Stustup/C-Audio_Schmupf_Amp_CASA/README.md

# Schmupf-Amp (CASA)
Small Stereo Headphone Amp with microphone passthrough fitting into a nice case.

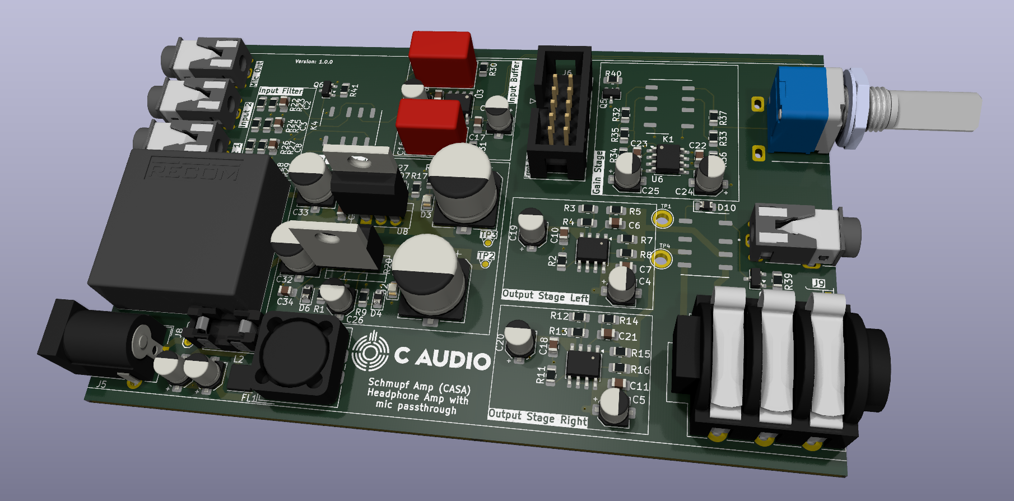
[picture p1: Docs/Mainbaord_3D-Model.png]
3D View of Mainboard


Simple leader follower parallel opamp topology.

# Signal Path 
Input -> Filter -> Input switch -> Input Buffer -> Volume control -> Voltage Gain Stage -> Current Gain Stage -> Output

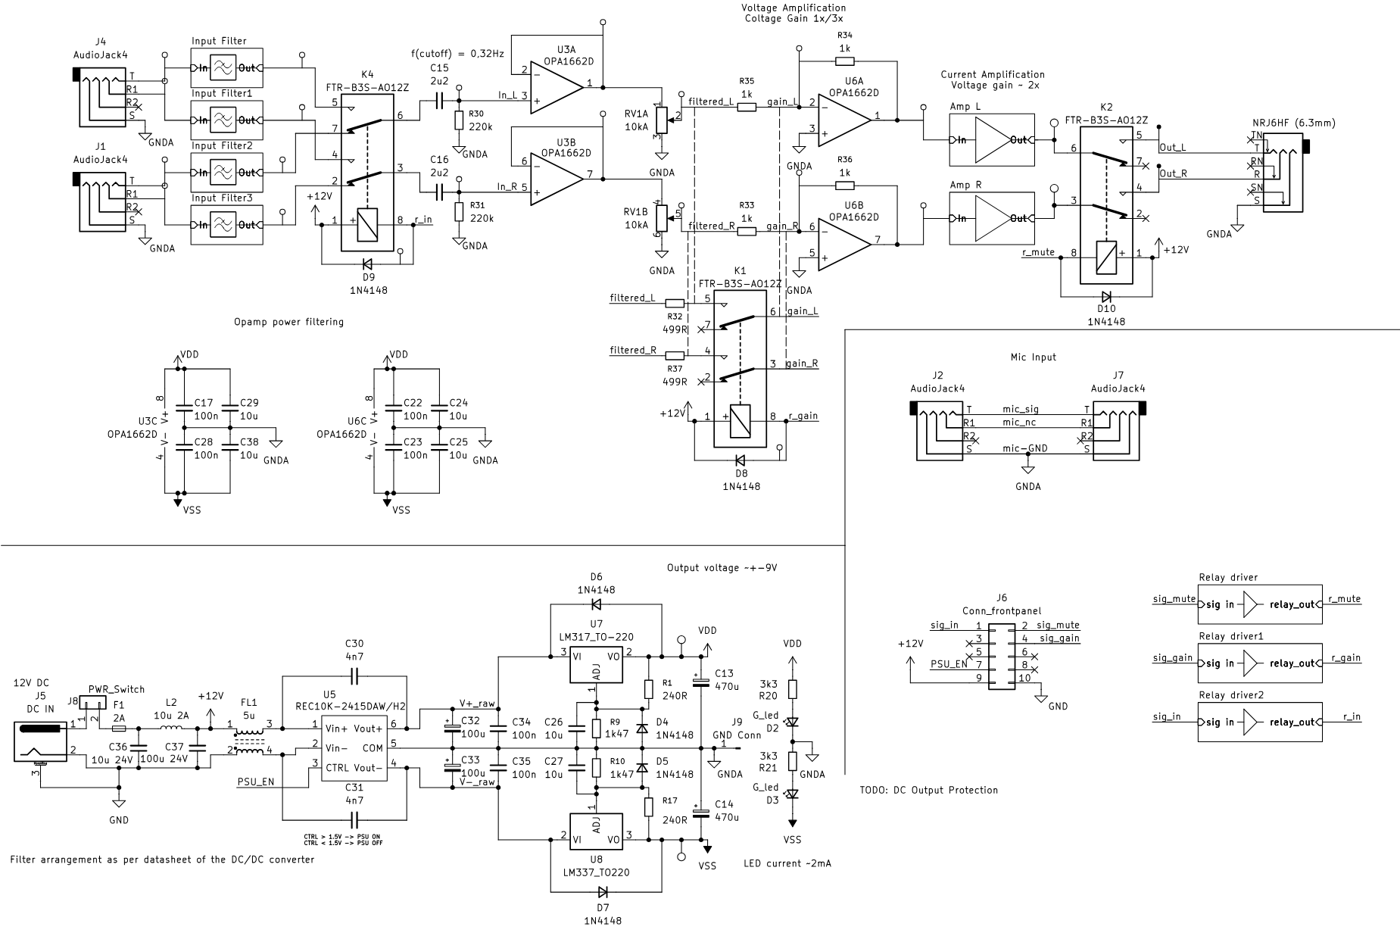
[picture p2: Docs/Schematic CASA.png]
Schematic


Bipolar linear post regulated power supply derived from 12V with a REC10K +-12V Module. Voltage for the opamps is +-9V.d
