Stustup/C-Audio_Schmupf_Amp_CASA/Docs/XRK Class A latest Version.jpg

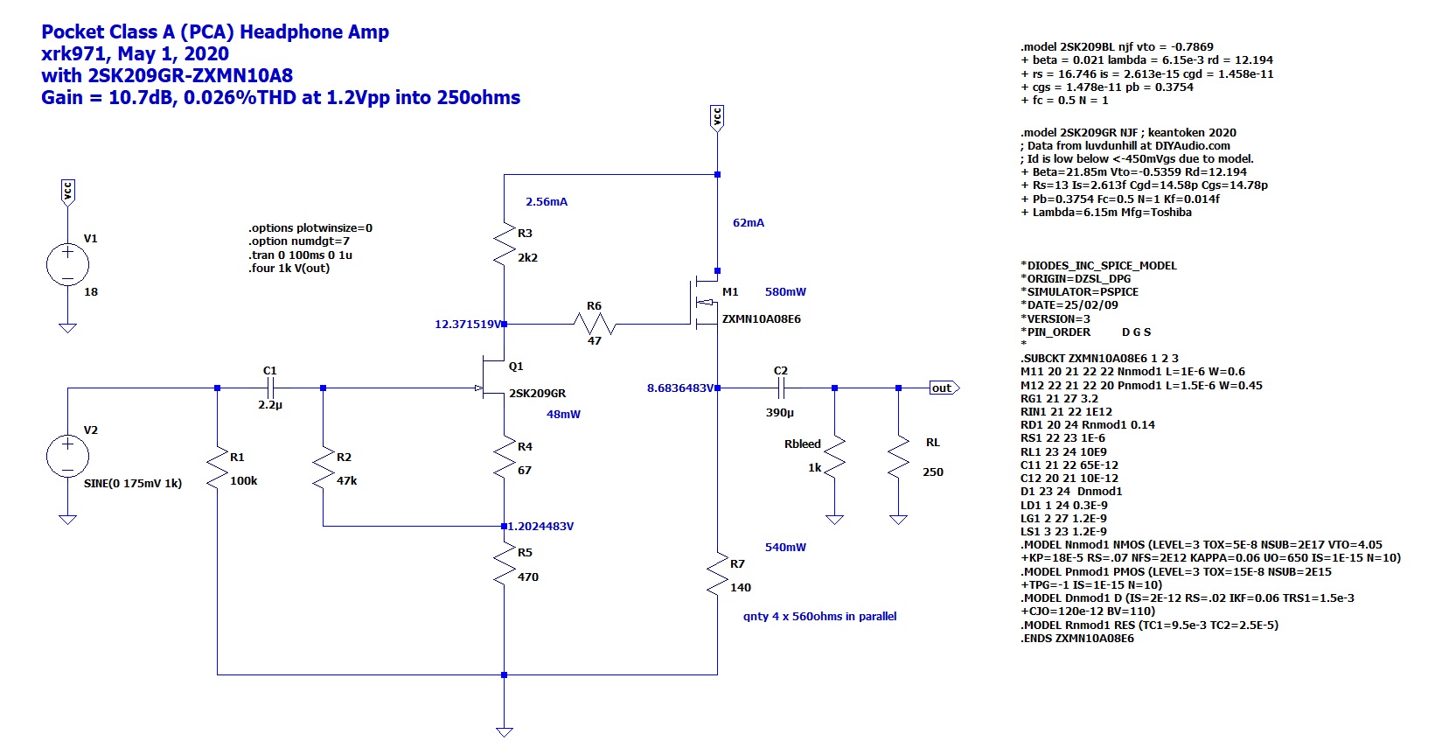
Docs/XRK Class A latest Version.jpg
