Stustup/C-Audio_Schmupf_Amp_CASA/Hardware/External Stuff/cliff-fc68125-1.snapshot.1/Screenshot 2020-02-27 at 16.49.09.png

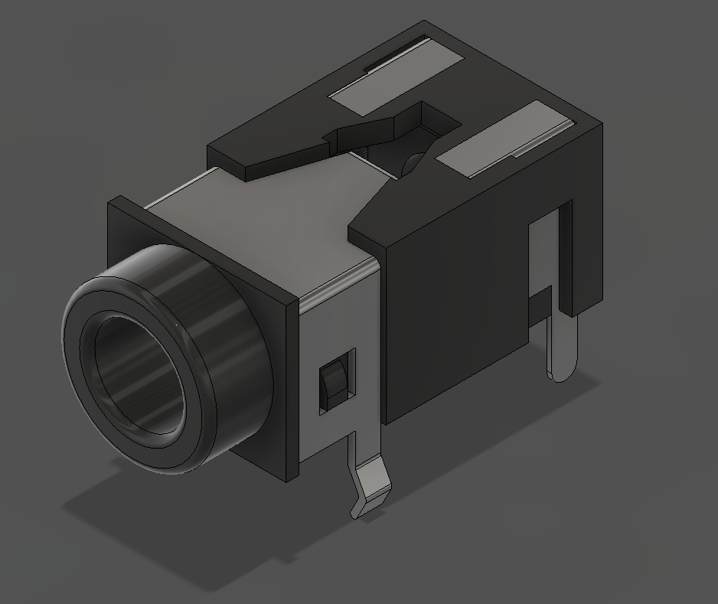
Hardware/External Stuff/cliff-fc68125-1.snapshot.1/Screenshot 2020-02-27 at 16.49.09.png
