Stustup/C-Audio_Schmupf_Amp_CASA/Hardware/Symbols/low pass filter.png

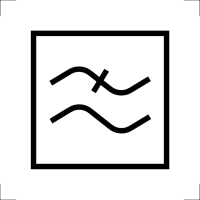
Hardware/Symbols/low pass filter.png
