Stustup/C-Audio_Schmupf_Amp_CASA/3D-CAD/Schmupf amp CASA.FCStd

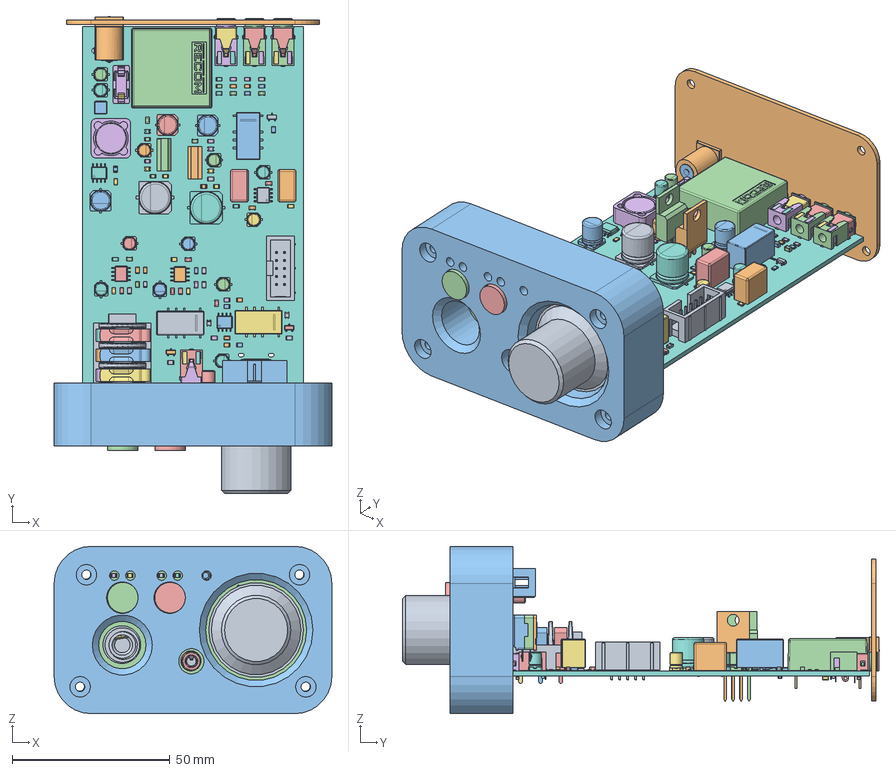
[picture p6: CAD file, 2026-03-26]
3D-CAD/Schmupf amp CASA.FCStd
88.0 x 151.1 x 53.0 mm
D_0805_2012Metric
LED_0805_2012Metric
CP_Elec_6.3x7.7
C_0805_2012Metric
C_0805_2012Metric001
R_0805_2012Metric
R_0805_2012Metric001
R_0805_2012Metric002
CP_Elec_10x10.5
R_0805_2012Metric003
R_0805_2012Metric004
C_0805_2012Metric002
Telo konektora
Kontakt most
Kontakt 1
Kontakt 002
Kontakt 2
R_0805_2012Metric005
C-Audio Schmupf Amp (CASA) 1.15.1
C-Audio Schmupf Amp (CASA) 1.15.002
C-Audio Schmupf Amp (CASA) 1.15.003
C-Audio Schmupf Amp (CASA) 1.15.004
C-Audio Schmupf Amp (CASA) 1.15.005
C-Audio Schmupf Amp (CASA) 1.15.006
C-Audio Schmupf Amp (CASA) 1.15.007
C-Audio Schmupf Amp (CASA) 1.15.008
C-Audio Schmupf Amp (CASA) 1.15.009
C-Audio Schmupf Amp (CASA) 1.15.010
SO-8_3.9x4.9mm_P1.27mm
R_0805_2012Metric006
D_0805_2012Metric001
CP_Elec_4x5.8
R_0805_2012Metric007
TO-220-3_Vertical
R_0805_2012Metric008
Telo konektora001
Kontakt most001
Kontakt 004
Kontakt 005
Kontakt 007
R_0805_2012Metric009
R_0805_2012Metric010
CP_Elec_4x5.009
TO-220-3_Vertical001
C_Rect_L10.3mm_W5.7mm_P7.50mm_MKS4
R_0805_2012Metric011
R_0805_2012Metric012
C_0805_2012Metric003
SOT-23
SO-8_3.9x4.9mm_P1.27mm001
R_0805_2012Metric013
C_0805_2012Metric004
CP_Elec_4x5.010
L_Bourns_SRR1260
D_0805_2012Metric002
CP_Elec_4x5.011
R_0805_2012Metric014
R_0805_2012Metric015
Relay_DPDT_Kemet_EE2_NU
R_0805_2012Metric016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
