Stustup/C-Audio_Schmupf_Amp_CASA/Hardware/3D-models/CP_Elec_4x5.8.step

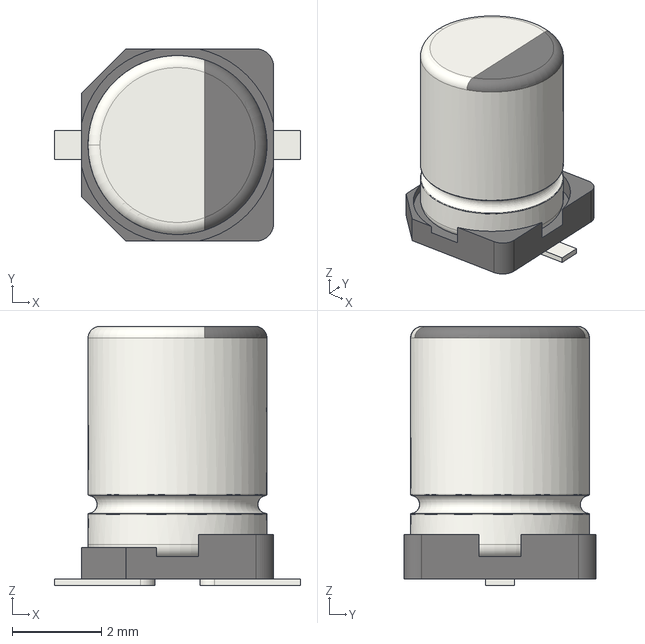
[picture p7: CAD file, 2025-12-11]
Hardware/3D-models/CP_Elec_4x5.8.step
5.50 x 4.30 x 5.80 mm
