Stustup/C-Audio_Schmupf_Amp_CASA/Hardware/C-Audio Schmupf Amp (CASA) Backplate/3D/C-Audio Schmupf Amp (CASA) Backplate.step

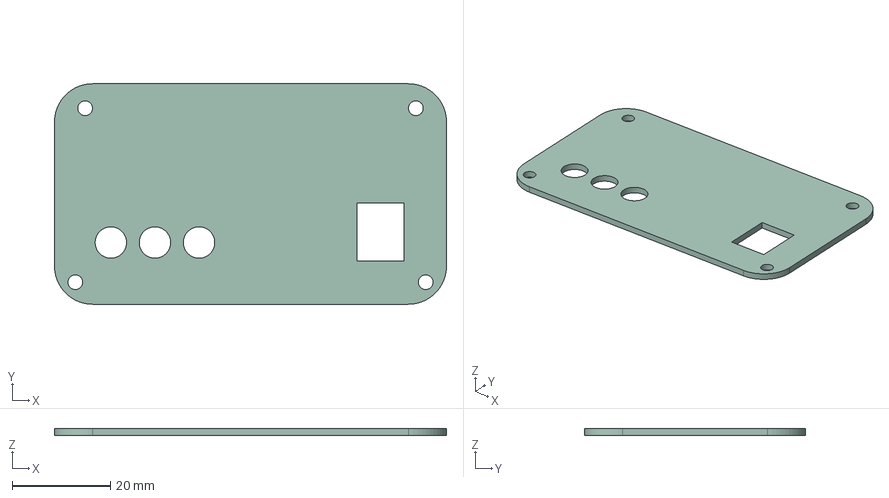
[picture p8: CAD file, 2025-12-11]
Hardware/C-Audio Schmupf Amp (CASA) Backplate/3D/C-Audio Schmupf Amp (CASA) Backplate.step
80.0 x 45.0 x 1.51 mm
