Stustup/C-Audio_Schmupf_Amp_CASA/Hardware/C-Audio Schmupf Amp (CASA) Backplate/backplate_CASA_dimensions.dxf

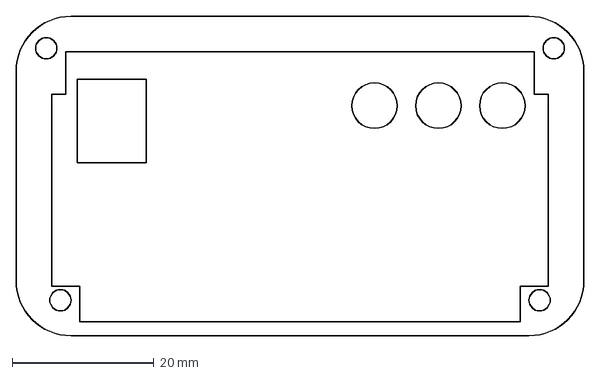
[picture p9: CAD file, 2025-12-11]
Hardware/C-Audio Schmupf Amp (CASA) Backplate/backplate_CASA_dimensions.dxf
80.0 x 45.0 mm
