Stustup/C-Audio_Schmupf_Amp_CASA/Hardware/C-Audio Schmupf Amp (CASA) Frontplate/Schmupf amp CASA_Frontplate.dxf

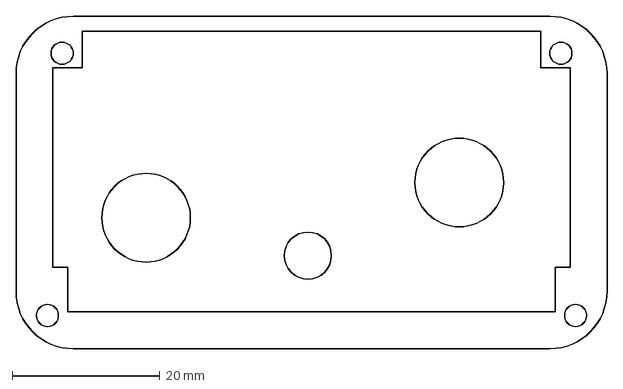
[picture p10: CAD file, 2025-12-11]
Hardware/C-Audio Schmupf Amp (CASA) Frontplate/Schmupf amp CASA_Frontplate.dxf
80.0 x 45.0 mm
