Stustup/C-Audio_Schmupf_Amp_CASA/Hardware/C-Audio Schmupf Amp (CASA).step

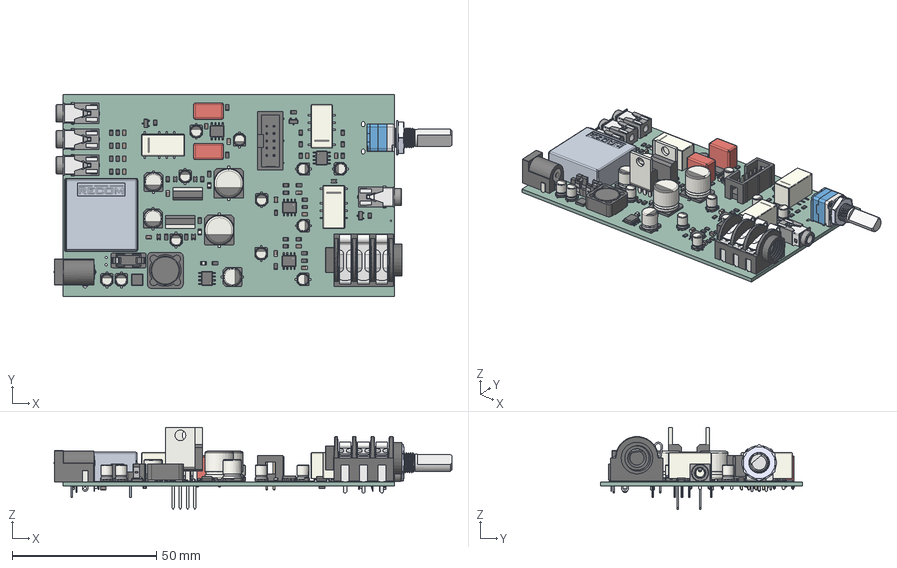
[picture p11: CAD file, 2025-12-11]
Hardware/C-Audio Schmupf Amp (CASA).step
138.0 x 70.0 x 28.5 mm
LED_0805_2012Metric x 3
CP_Elec_6.3x7.7 x 3
C_0805_2012Metric x 18
R_0805_2012Metric x 38
CP_Elec_10x10.5 x 2
Telo konektora x 4
Kontakt most x 4
Kontakt 1 x 4
Kontakt 2 x 4
C-Audio Schmupf Amp (CASA) 1.14.1
SO-8_3.9x4.9mm_P1.27mm x 2
D_0805_2012Metric x 7
CP_Elec_4x5.8 x 12
TO-220-3_Vertical x 2
C_Rect_L10.3mm_W5.7mm_P7.50mm_MKS4 x 2
SOT-23 x 3
L_Bourns_SRR1260
Relay_DPDT_Kemet_EE2_NU x 3
SOIC-8_3.9x4.9mm_P1.27mm x 3
IDC-Header_2x05_P2.54mm_Vertical
RK097x-Cover
RK097x-Housing2
NMJ6HCD2
BarrelJack_Horizontal
Fuseholder_Schurter_0031.7701.xx
L_APV_ANR4010
C-Audio Schmupf Amp (CASA)_PCB
