Stustup/C-Audio_Schmupf_Amp_CASA/Hardware/3D-models/Audio Jack 3.5 mm  Cliff FC68125.step

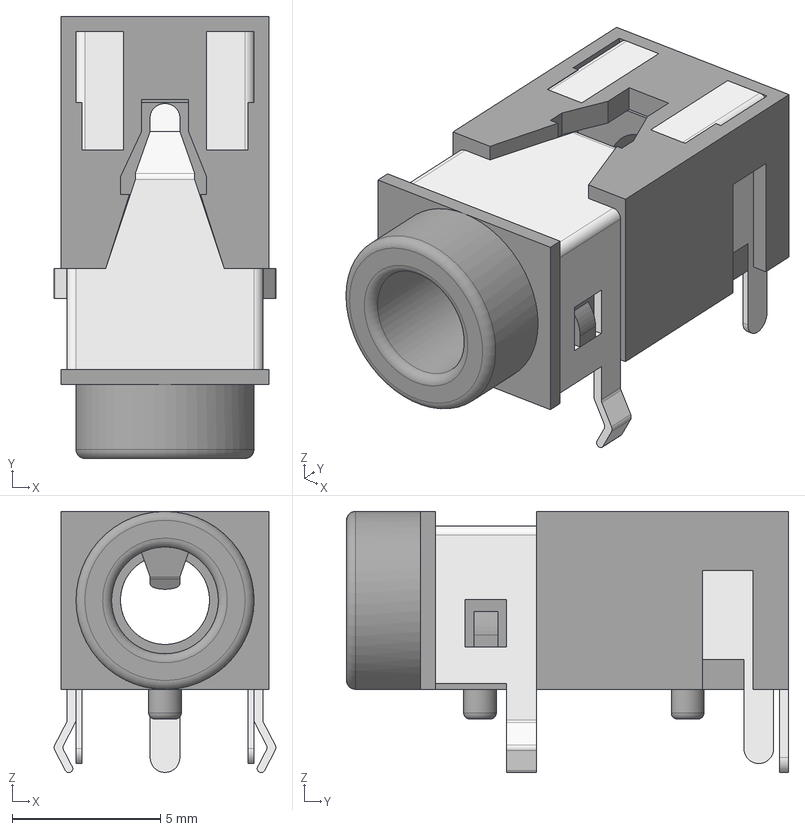
[picture p12: CAD file, 2025-12-11]
Hardware/External Stuff/cliff-fc68125-1.snapshot.1/Audio Jack 3.5 mm Cliff FC68125.step
7.47 x 14.9 x 8.81 mm
Telo konektora
Kontakt most
Kontakt 1
Kontakt 2
