Stustup/C-Audio_Schmupf_Amp_CASA/Hardware/REC10K-2415DAW_H2/REC10K-2415DAW_H2.STEP

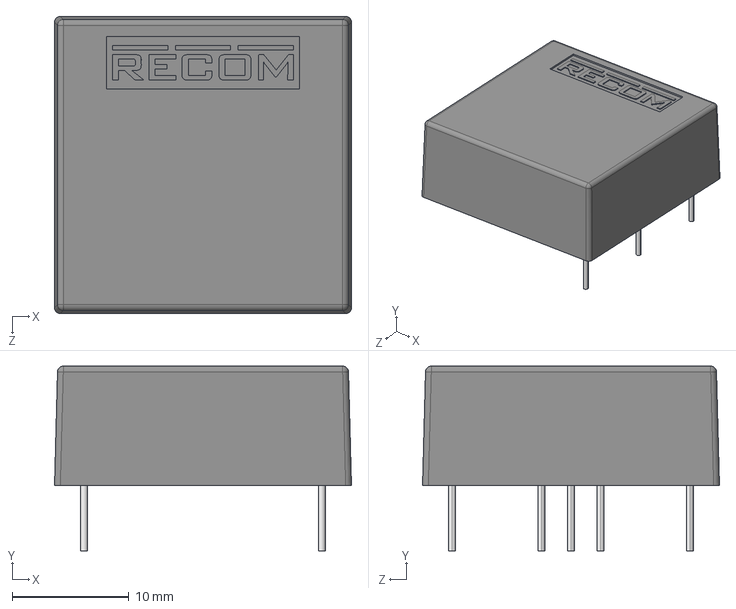
[picture p13: CAD file, 2025-12-11]
Hardware/REC10K-2415DAW_H2/REC10K-2415DAW_H2.STEP
25.4 x 15.8 x 25.4 mm
