Stustup/C-Audio_Schmupf_Amp_CASA/Hardware/TechDraw/Schmupf amp CASA_Frontplate.dxf

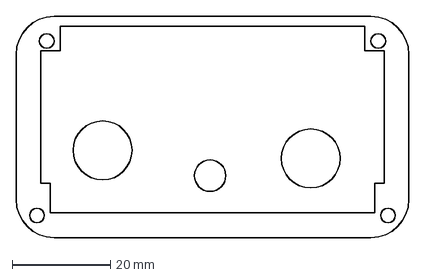
[picture p14: CAD file, 2025-12-11]
Hardware/TechDraw/Schmupf amp CASA_Frontplate.dxf
80.0 x 45.0 mm
