Stustup/C-Audio_Schmupf_Amp_CASA/3D-CAD/C-Audio Schmupf Amp (CASA) Frontplate.step

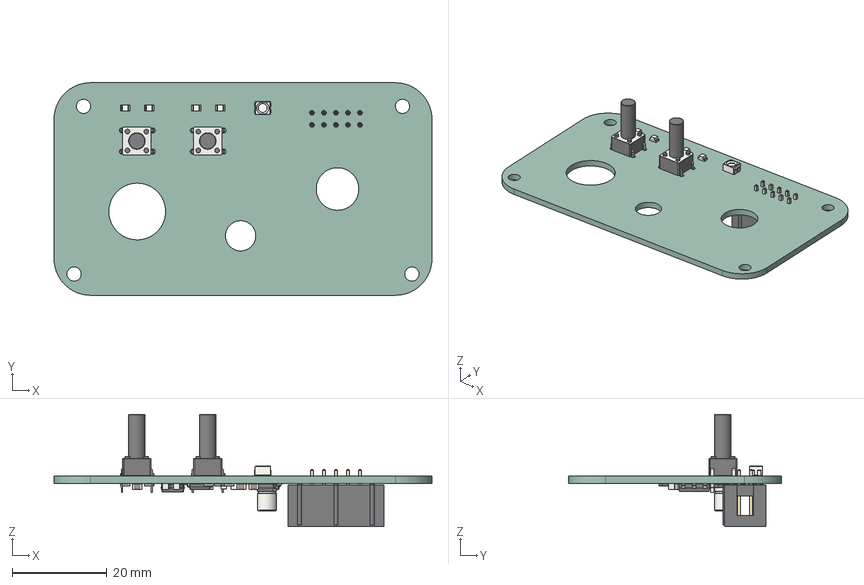
[picture p15: CAD file, 2026-01-21]
3D-CAD/C-Audio Schmupf Amp (CASA) Frontplate.step
80.0 x 45.0 x 23.8 mm
LED_0805_2012Metric x 5
SW_PUSH_6mm_H13mm x 2
LED_RGB_Wuerth-PLCC4_3.2x2.8mm_150141M173100
SOIC-8_3.9x4.9mm_P1.27mm
SOT-23 x 3
TSSOP-20_4.4x6.5mm_P0.65mm
R_0805_2012Metric x 15
IDC-Header_2x05_P2.54mm_Vertical
C_0805_2012Metric x 7
CP_Elec_4x5.8
SOT-223
C-Audio Schmupf Amp (CASA) Frontplate_PCB
