Stustup/C-Audio_Schmupf_Amp_CASA/Hardware/3D-models/SO-8_3.9x4.9mm_P1.27mm.step

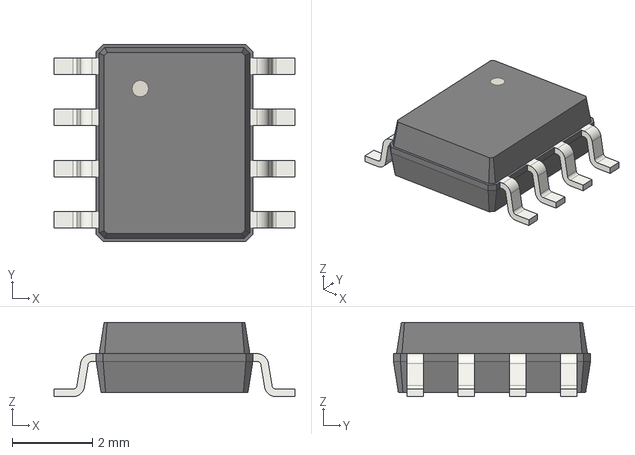
[picture p16: CAD file, 2025-12-11]
Hardware/3D-models/SO-8_3.9x4.9mm_P1.27mm.step
6.00 x 4.91 x 1.85 mm
