Stustup/C-Audio_Schmupf_Amp_CASA/Hardware/3D-models/LED_0805_2012Metric.step

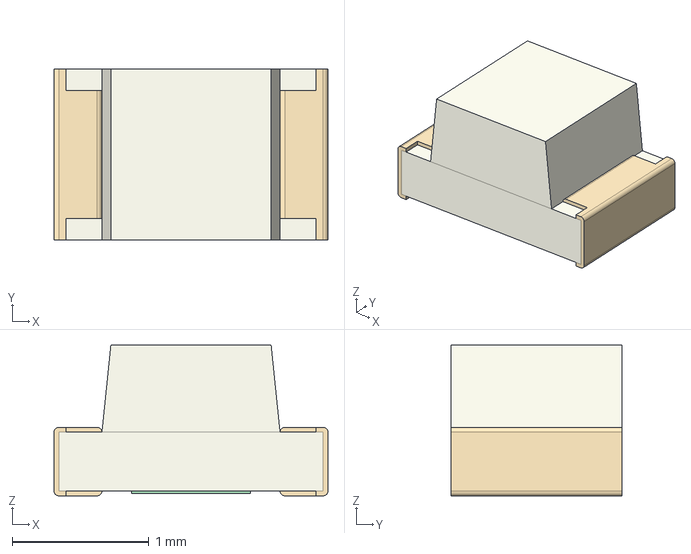
[picture p17: CAD file, 2025-12-11]
Hardware/3D-models/LED_0805_2012Metric.step
2.00 x 1.25 x 1.10 mm
