Stustup/C-Audio_Schmupf_Amp_CASA/Hardware/3D-models/L_APV_ANR4010.step

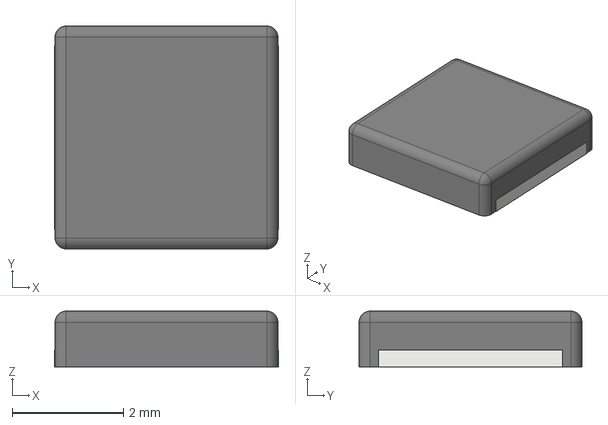
[picture p18: CAD file, 2025-12-11]
Hardware/3D-models/L_APV_ANR4010.step
4.02 x 4.00 x 1.00 mm
