Stustup/C-Audio_Schmupf_Amp_CASA/Hardware/3D-models/NMJ6HCD2.step

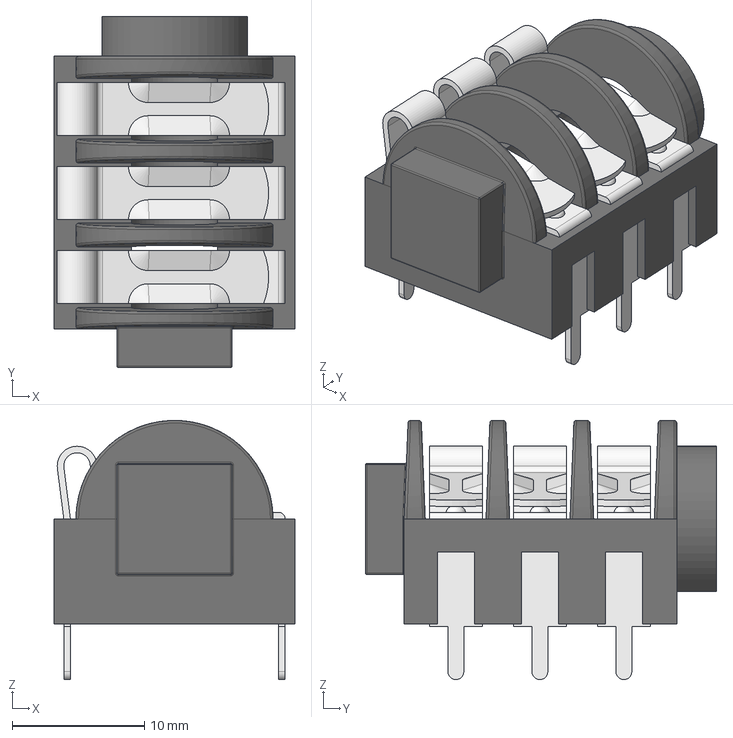
[picture p19: CAD file, 2025-12-11]
Hardware/3D-models/NMJ6HCD2.step
18.2 x 26.5 x 19.6 mm
