Stustup/C-Audio_Schmupf_Amp_CASA/Hardware/3D-models/L_Bourns_SRR1260.step

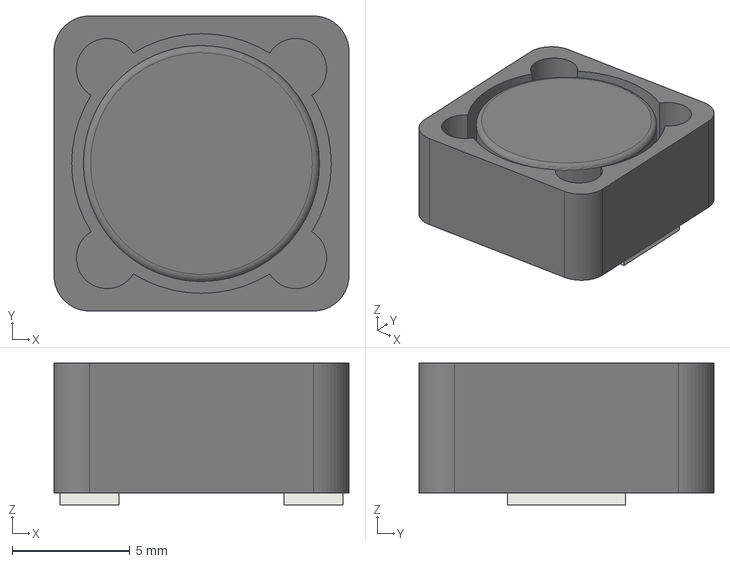
[picture p20: CAD file, 2025-12-11]
Hardware/3D-models/L_Bourns_SRR1260.step
12.5 x 12.5 x 6.00 mm
