Stustup/C-Audio_Schmupf_Amp_CASA/Hardware/3D-models/BarrelJack_Horizontal.step

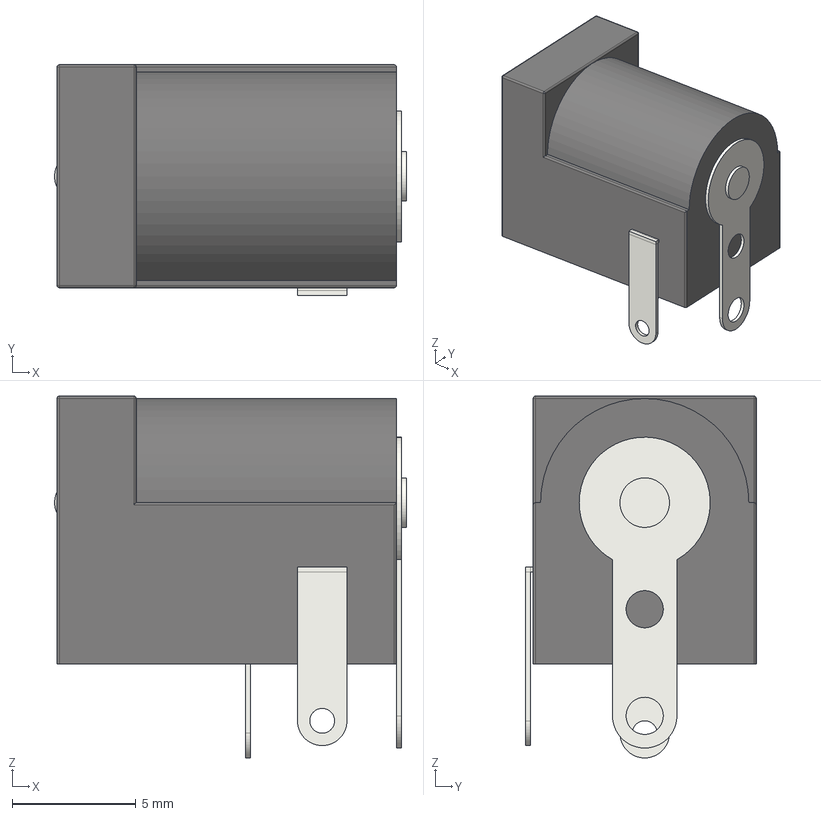
[picture p21: CAD file, 2025-12-11]
Hardware/3D-models/BarrelJack_Horizontal.step
14.2 x 9.30 x 14.6 mm
