Stustup/C-Audio_Schmupf_Amp_CASA/Hardware/3D-models/D_0805_2012Metric.step

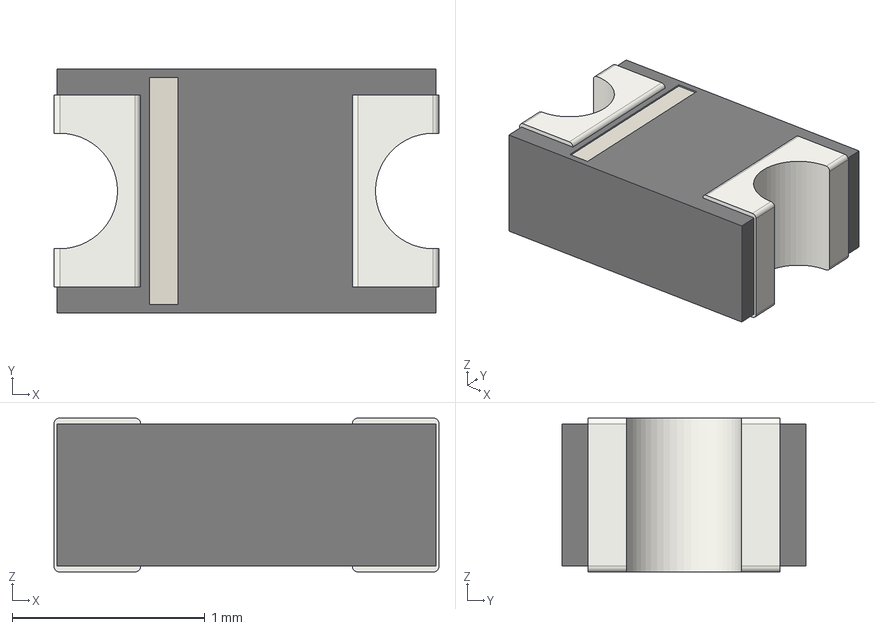
[picture p22: CAD file, 2025-12-11]
Hardware/3D-models/D_0805_2012Metric.step
2.00 x 1.27 x 0.8 mm
