Stustup/C-Audio_Schmupf_Amp_CASA/Hardware/3D-models/C_0805_2012Metric.step

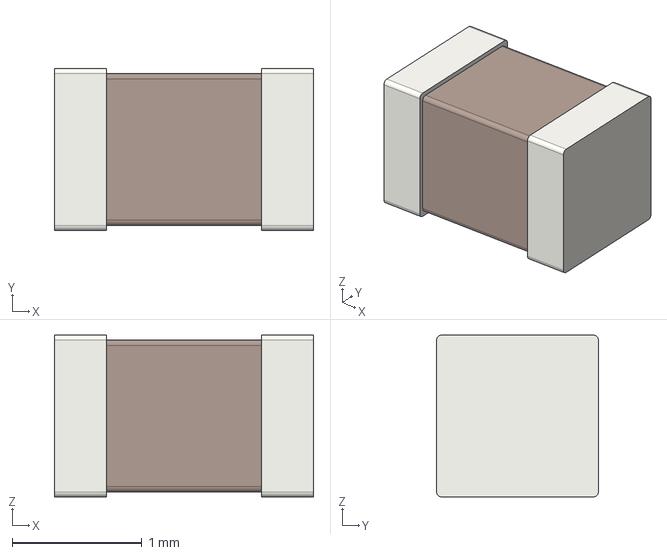
[picture p23: CAD file, 2025-12-11]
Hardware/3D-models/C_0805_2012Metric.step
2.00 x 1.25 x 1.25 mm
