Stustup/C-Audio_Schmupf_Amp_CASA/Hardware/3D-models/Fuseholder_Schurter_0031.7701.xx.step

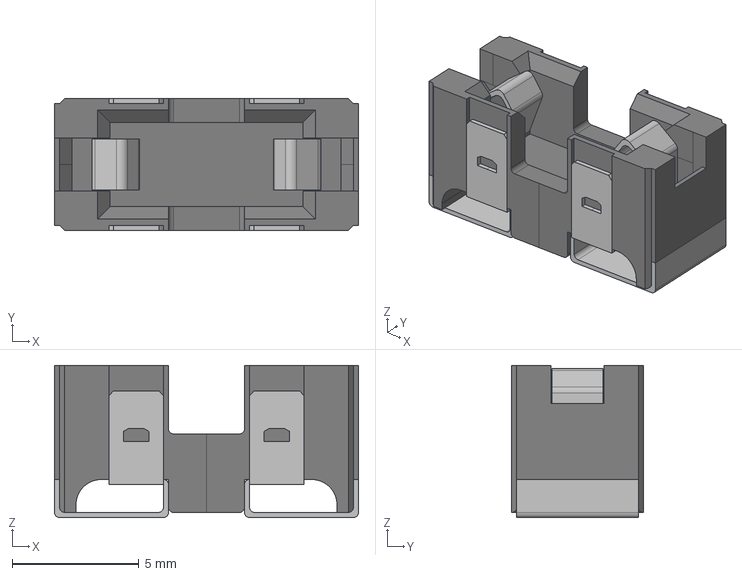
[picture p24: CAD file, 2025-12-11]
Hardware/3D-models/Fuseholder_Schurter_0031.7701.xx.step
12.0 x 5.20 x 6.00 mm
