Stustup/C-Audio_Schmupf_Amp_CASA/Hardware/3D-models/SOT-23.step

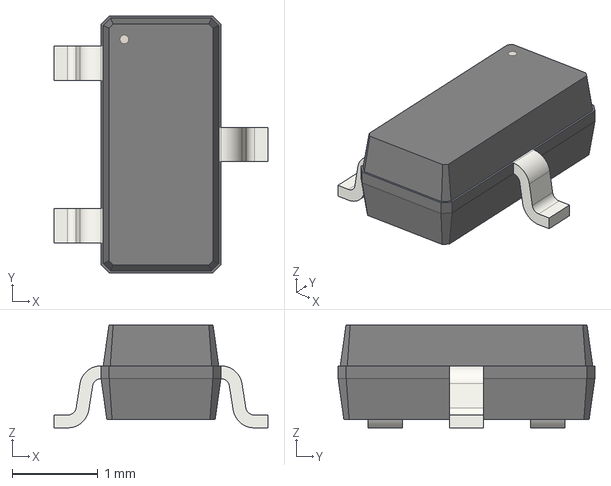
[picture p25: CAD file, 2025-12-11]
Hardware/3D-models/SOT-23.step
2.50 x 3.00 x 1.20 mm
