Stustup/C-Audio_Schmupf_Amp_CASA/Hardware/3D-models/TO-220-3_Vertical.step

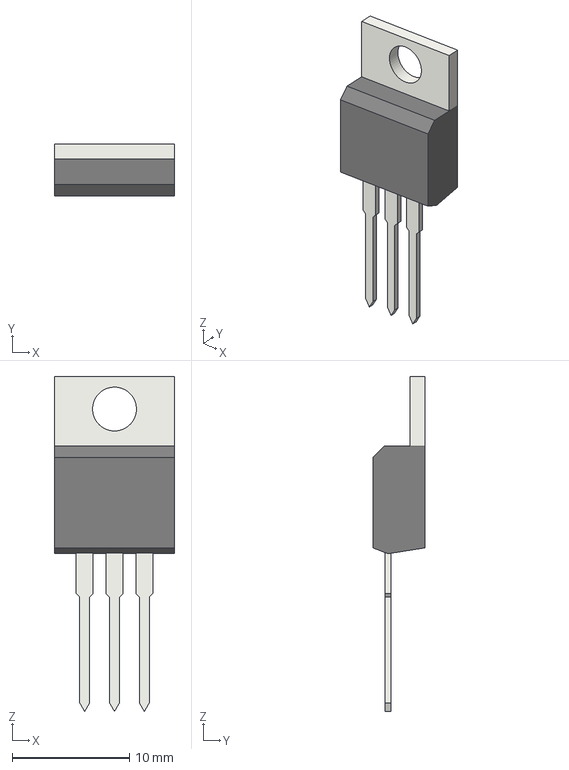
[picture p26: CAD file, 2025-12-11]
Hardware/3D-models/TO-220-3_Vertical.step
10.2 x 4.46 x 28.5 mm
