Stustup/C-Audio_Schmupf_Amp_CASA/Hardware/3D-models/C_Rect_L10.3mm_W5.7mm_P7.50mm_MKS4.step

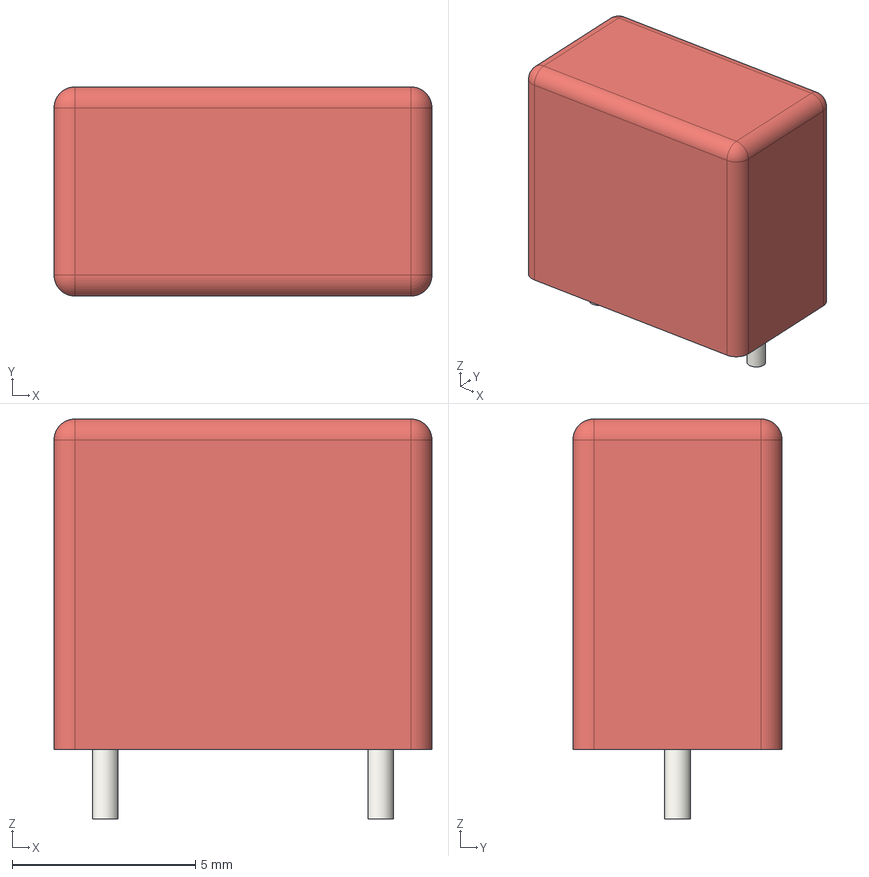
[picture p27: CAD file, 2025-12-11]
Hardware/3D-models/C_Rect_L10.3mm_W5.7mm_P7.50mm_MKS4.step
10.3 x 5.70 x 10.9 mm
