Stustup/C-Audio_Schmupf_Amp_CASA/Hardware/3D-models/Relay_DPDT_Kemet_EE2_NU.step

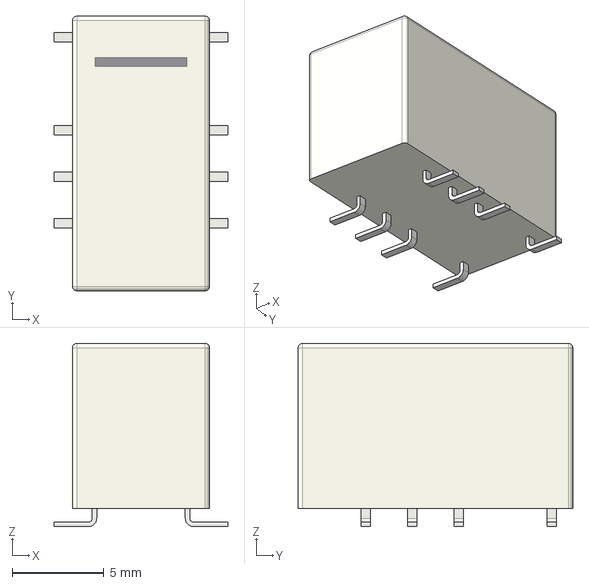
[picture p28: CAD file, 2025-12-11]
Hardware/3D-models/Relay_DPDT_Kemet_EE2_NU.step
9.50 x 15.0 x 10.0 mm
