Stustup/C-Audio_Schmupf_Amp_CASA/Hardware/3D-models/CP_Elec_10x10.5.step

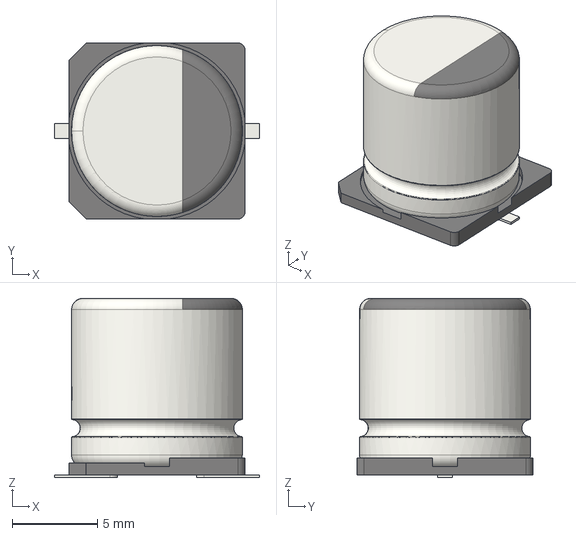
[picture p29: CAD file, 2025-12-11]
Hardware/3D-models/CP_Elec_10x10.5.step
12.0 x 10.3 x 10.5 mm
