Stustup/C-Audio_Schmupf_Amp_CASA/Hardware/3D-models/IDC-Header_2x05_P2.54mm_Vertical.step

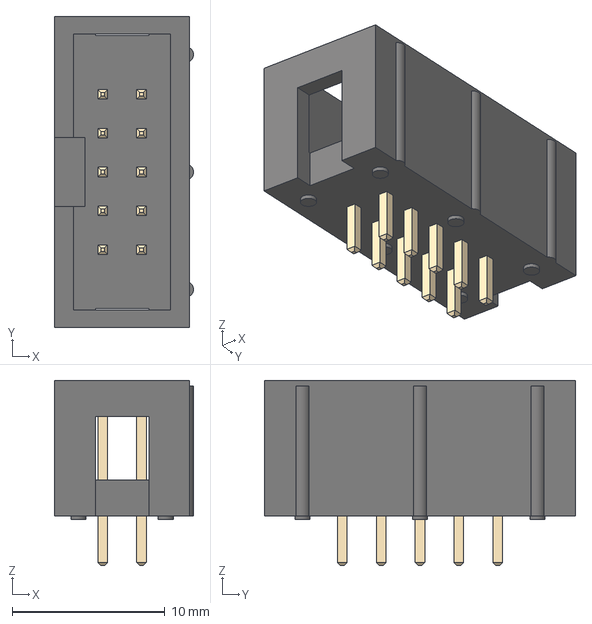
[picture p30: CAD file, 2025-12-11]
Hardware/3D-models/IDC-Header_2x05_P2.54mm_Vertical.step
9.10 x 20.4 x 12.1 mm
