Stustup/C-Audio_Schmupf_Amp_CASA/Hardware/3D-models/SOIC-8_3.9x4.9mm_P1.27mm.step

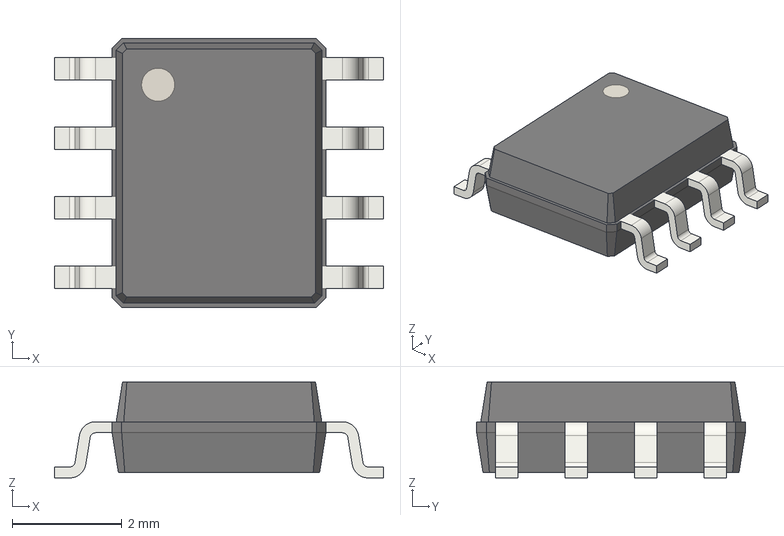
[picture p31: CAD file, 2025-12-11]
Hardware/3D-models/SOIC-8_3.9x4.9mm_P1.27mm.step
6.00 x 4.90 x 1.75 mm
