Stustup/C-Audio_Schmupf_Amp_CASA/Hardware/3D-models/RK0972-L-20F_N-7.step

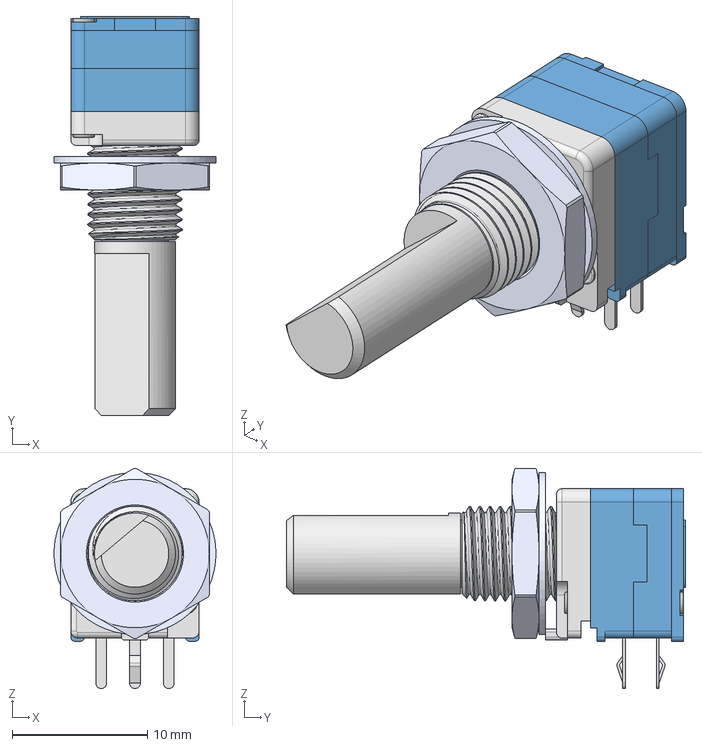
[picture p32: CAD file, 2025-12-11]
Hardware/3D-models/RK0972-L-20F_N-7.step
12.0 x 29.6 x 16.3 mm
