Stustup/C-Audio_Schmupf_Amp_CASA/Hardware/3D-models/CP_Elec_6.3x7.7.step

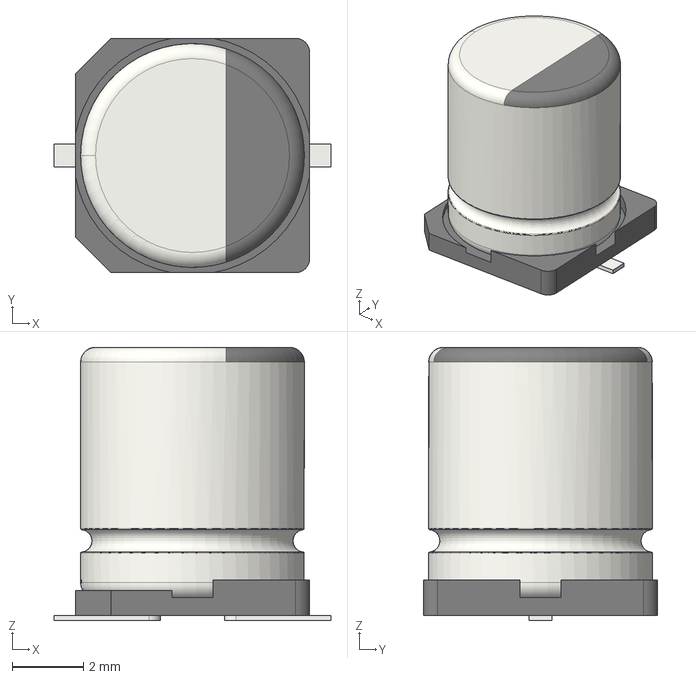
[picture p34: CAD file, 2025-12-11]
Hardware/3D-models/CP_Elec_6.3x7.7.step
7.80 x 6.60 x 7.70 mm
