Stustup/C-Audio_Schmupf_Amp_CASA/(list of files, cad)

Other CAD files:
Hardware/Old Version/CASA old/CASA Frontplate-Sketch.dxf
