Stustup/C-Audio_Schmupf_Amp_CASA/3D-CAD/Frontplate Drill Template.pdf

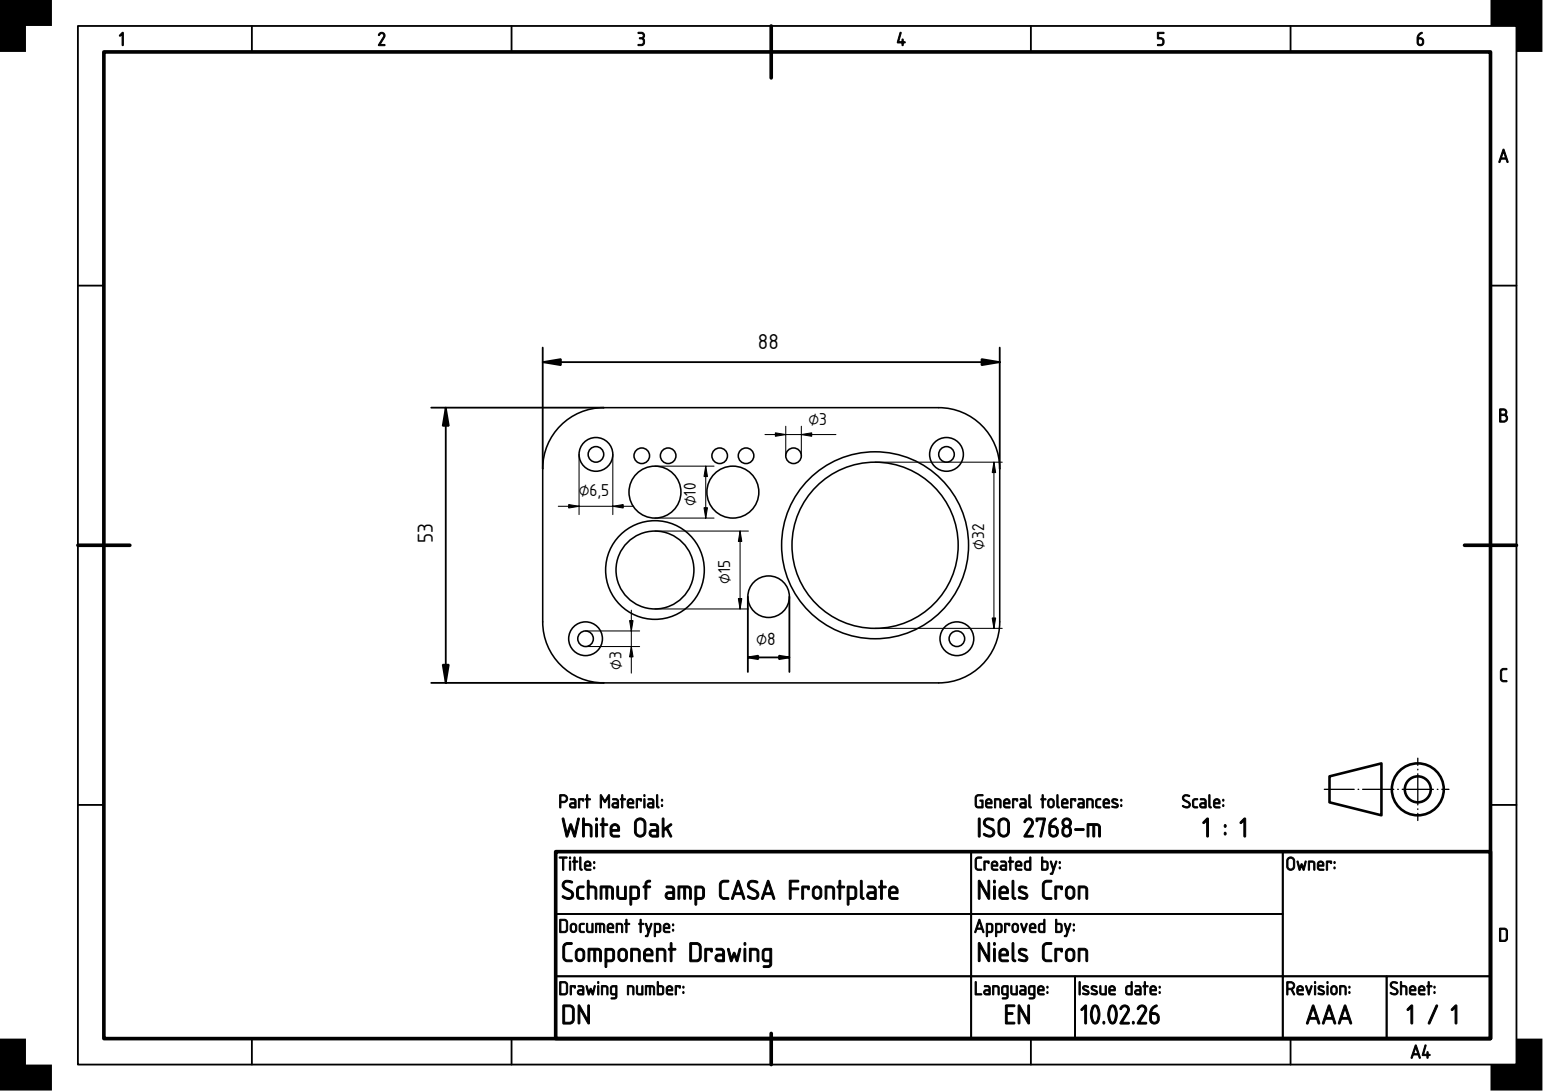
[picture p35: page 1]
