Stustup/C-Audio_Schmupf_Amp_CASA/Hardware/Sim/Draft1.asc

A1: schmtbuf
C1: cap; 100µ
M1: nmos; IRF7309N
Q1: npn; 2N2222
R1: res; 220k
R2: res; 220k
R3: res; 500R
R4: res; 10k
U1: LT1018
V1: voltage; 5
Named nets: V+, 0
.tran 30 startup
