Stustup/C-Audio_Schmupf_Amp_CASA/Hardware/Sim/Schmupf Amp Sim.asc

C1: cap; 100p
R1: res; 330
R2: res; 1k
R3: res; 3
R4: res; 3
R5: res; 10k
R6: res; 32
U1: opamp2; OPA168x
U2: opamp2; OPA168x
V1: voltage; 12
V2: voltage; 12
V3: voltage; SINE(0 1 1k)
Named nets: 0, V-, V+, sig, Output
.tran 0 200m 100m uic
.include OPA168x.LIB
.four 1k 8 -1 V(n002)
Total Harmonic Distortion: 0.028812%(0.079799%) Test 1 (1R Out)
Total Harmonic Distortion: 0.027042%(0.079851%) Test 2 (3R out)
.include OPA160x.LIB
Total Harmonic Distortion: 0.027942%(0.076839%) Test 3 (OPA1602 input)
