Stustup/C-Audio_Schmupf_Amp_CASA/Hardware/C-Audio Schmupf Amp (CASA).kicad_pcb

## KiCad design Hardware/C-Audio Schmupf Amp (CASA).kicad_pcb (2026-06-09)

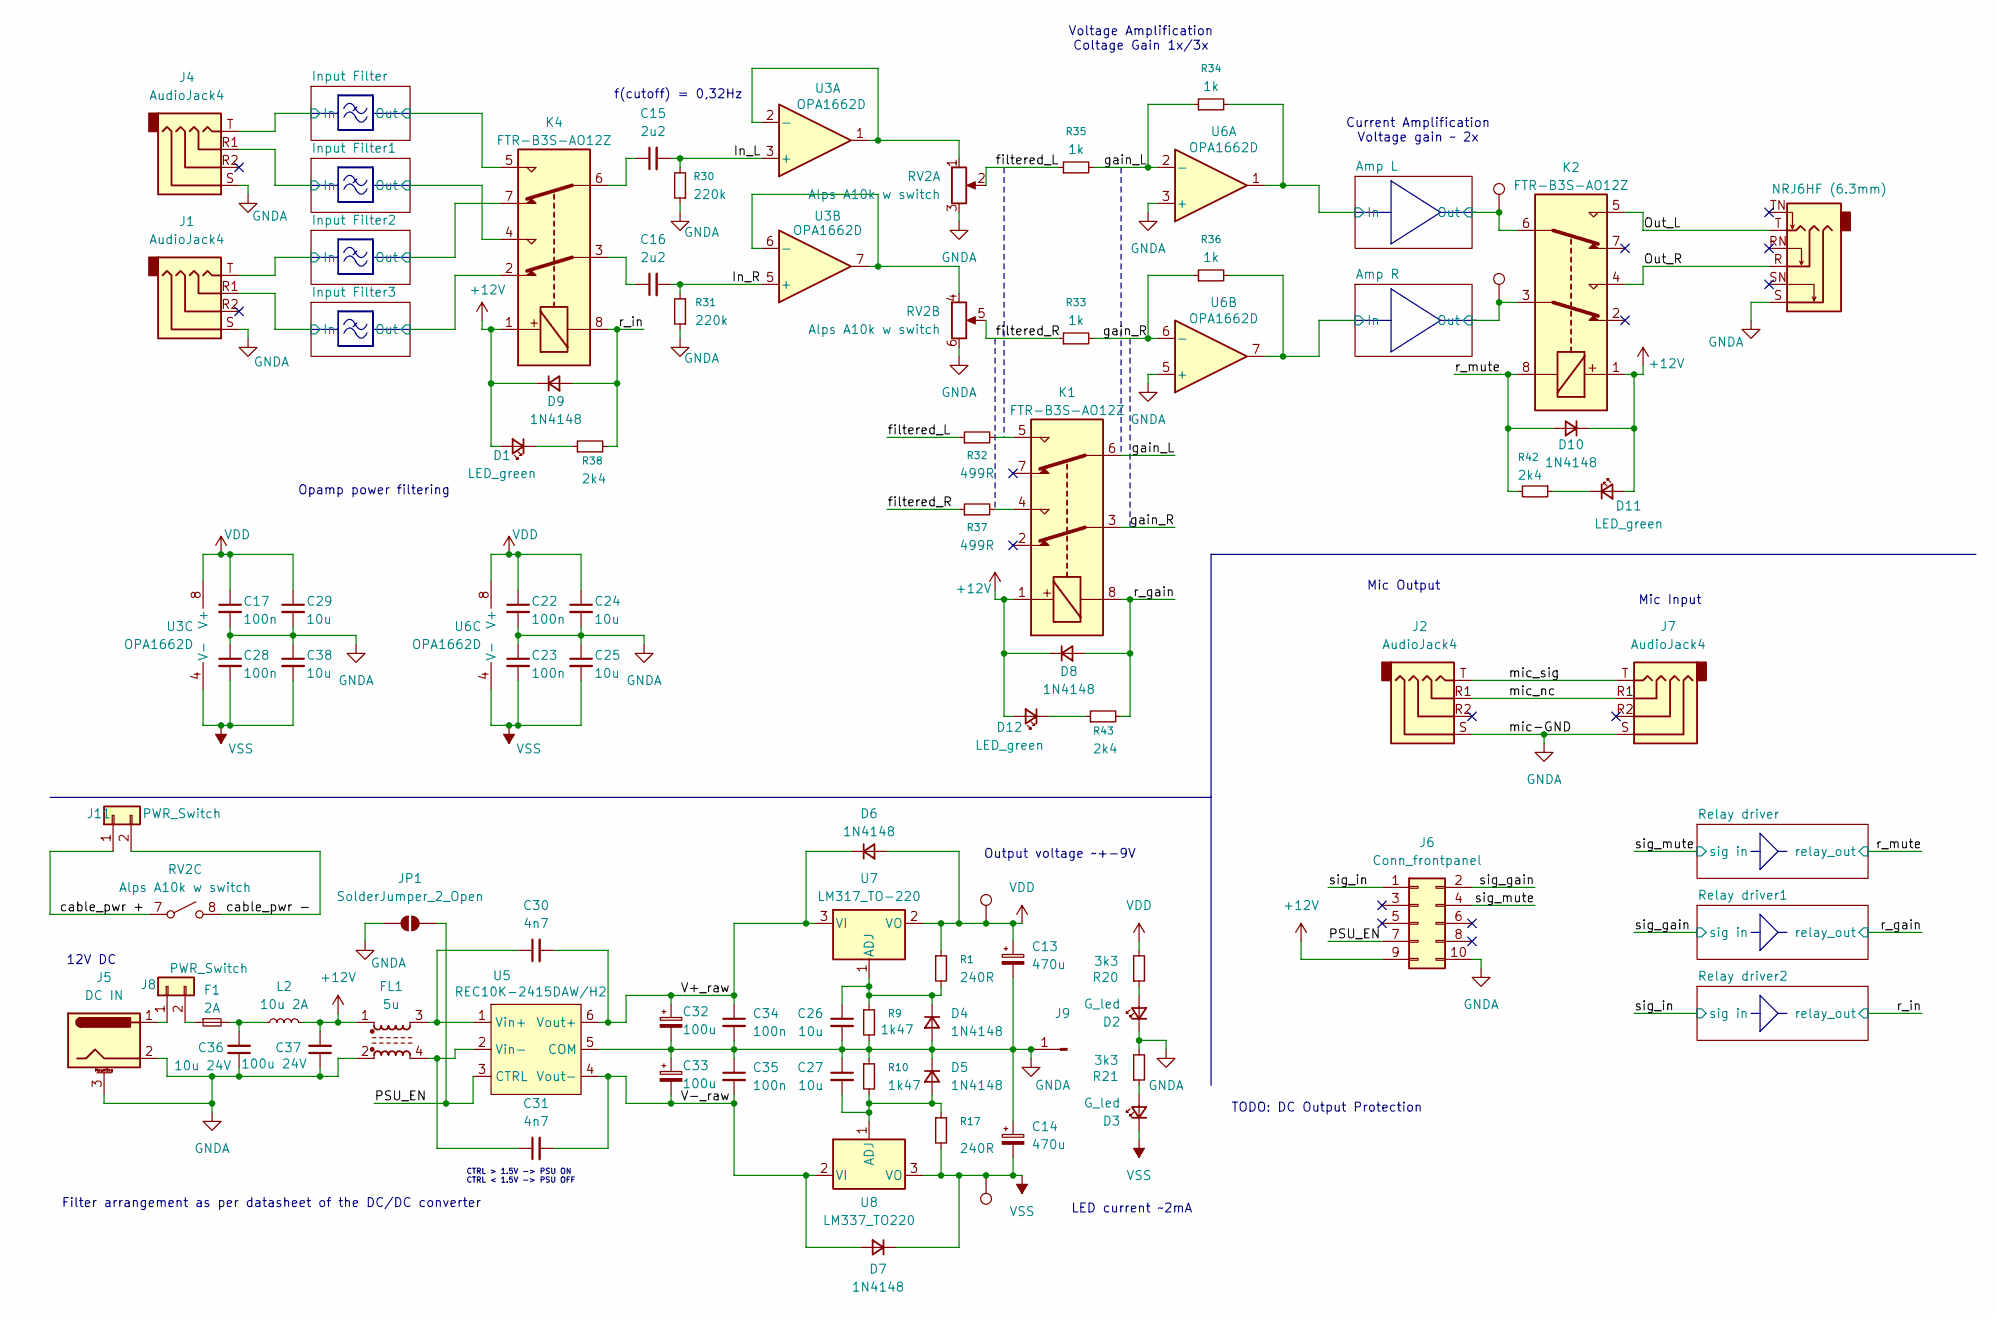
[picture p36: schematic C-Audio Schmupf Amp (CASA).kicad_sch, Schmupf Amp (CASA)]

Parts:
C13, C14: 470u; CP_Elec_10x10.5
C15, C16: 2u2; C_Rect_L10.3mm_W5.7mm_P7.50mm_MKS4
C17, C22, C23, C28, C34, C35: 100n; C_0805_2012Metric_Pad1.18x1.45mm_HandSolder
C24, C25, C26, C27, C29, C38: 10u; CP_Elec_4x5.8
C30, C31: 4n7; C_0805_2012Metric_Pad1.18x1.45mm_HandSolder
C32, C33: 100u; CP_Elec_6.3x7.7
C36: 10u 24V; CP_Elec_4x5.8
C37: 100u 24V; CP_Elec_4x5.8
D1, D11, D12: LED_green; LED_0805_2012Metric_Pad1.15x1.40mm_HandSolder
D2, D3: G_led; LED_0805_2012Metric
D4, D5, D6, D7, D8, D9, D10: 1N4148; D_0805_2012Metric_Pad1.15x1.40mm_HandSolder
F1: 2A; Fuseholder_Littelfuse_Nano2_154x
FL1: 5u; L_Bourns_SRF1260
J1, J2, J4, J7: AudioJack4; CLIFF_FC68125
J3: NRJ6HF (6.3mm); Jack_6.35mm_Neutrik_NMJ6HFD2_Horizontal
J5: DC IN; BarrelJack_CUI_PJ-102AH_Horizontal
J6: Conn_frontpanel; IDC-Header_2x05_P2.54mm_Vertical
J8, J11: PWR_Switch; TestPoint_2Pads_Pitch2.54mm_Drill0.8mm
J9: GND Conn; PinHeader_1x01_P1.00mm_Vertical
JP1: SolderJumper_2_Open; SolderJumper-2_P1.3mm_Open_TrianglePad1.0x1.5mm
K1, K2, K4: FTR-B3S-AO12Z; Relay_Fujitsu_FTR-B3S
L2: 10u 2A; L_APV_ANR4010
R1, R17: 240R; R_0805_2012Metric_Pad1.20x1.40mm_HandSolder
R9, R10: 1k47; R_0805_2012Metric_Pad1.20x1.40mm_HandSolder
R20, R21: 3k3; R_0805_2012Metric_Pad1.20x1.40mm_HandSolder
R30, R31: 220k; R_0805_2012Metric_Pad1.20x1.40mm_HandSolder
R32, R37: 499R; R_0805_2012Metric_Pad1.20x1.40mm_HandSolder
R33, R34, R35, R36: 1k; R_0805_2012Metric_Pad1.20x1.40mm_HandSolder
R38, R42, R43: 2k4; R_0805_2012Metric_Pad1.20x1.40mm_HandSolder
RV2: Alps A10k w switch; Potentiometer_Alps_RK097_Dual_Horizontal_Switch
TP1, TP4: TestPoint; TestPoint_Plated_Hole_D2.0mm
TP2: VDD; TestPoint_Pad_D1.0mm
TP3: VSS; TestPoint_Pad_D1.0mm
U3, U6: OPA1662D; SOIC-8_3.9x4.9mm_P1.27mm
U5: REC10K-2415DAW/H2; REC10K-2415DAWH2
U7: LM317_TO-220; TO-220-3_Vertical
U8: LM337_TO220; TO-220-3_Vertical

Connections:
+12V: C37.2, D1.2 (A), D8.1 (K), D9.1 (K), D10.1 (K), D11.2 (A), D12.2 (A), FL1.1, J6.9, K1.1, K2.1, K4.1, L2.2
/Amp L/In: R34.2, U6.1; also elsewhere on the board
/Amp L/Out: K2.6, TP1.1; also elsewhere on the board
/Amp R/In: R36.2, U6.7; also elsewhere on the board
/Amp R/Out: K2.3, TP4.1; also elsewhere on the board
/In_L: C15.2, R30.2, U3.3 (+)
/In_R: C16.2, R31.2, U3.5 (+)
/Input Filter1/In: J4.R1; also elsewhere on the board
/Input Filter1/Out: K4.4; also elsewhere on the board
/Input Filter2/In: J1.T; also elsewhere on the board
/Input Filter2/Out: K4.7; also elsewhere on the board
/Input Filter3/In: J1.R1; also elsewhere on the board
/Input Filter3/Out: K4.2; also elsewhere on the board
/Input Filter/In: J4.T; also elsewhere on the board
/Input Filter/Out: K4.5; also elsewhere on the board
/Out_L: J3.T, K2.5
/Out_R: J3.R, K2.4
/PSU_EN: J6.7, JP1.1 (A), U5.3 (CTRL)
/V+_raw: C30.2, C32.1, C34.1, D6.1 (K), U5.6 (Vout+), U7.3 (VI)
/V-_raw: C31.2, C33.2, C35.2, D7.2 (A), U5.4 (Vout-), U8.2 (VI)
/cable_pwr +: J11.1, RV2.7
/cable_pwr -: J11.2, RV2.8
/filtered_L: R32.1, R35.1, RV2.2
/filtered_R: R33.1, R37.1, RV2.5
/gain_L: K1.6, R34.1, R35.2, U6.2 (-)
/gain_R: K1.3, R33.2, R36.1, U6.6 (-)
/mic_nc: J2.R1, J7.R1
/mic_sig: J2.T, J7.T
/r_gain: D8.2 (A), K1.8, R43.2; also elsewhere on the board
/r_in: D9.2 (A), K4.8, R38.2; also elsewhere on the board
/r_mute: D10.2 (A), K2.8, R42.2; also elsewhere on the board
/sig_gain: J6.2; also elsewhere on the board
/sig_in: J6.1; also elsewhere on the board
/sig_mute: J6.4; also elsewhere on the board
GNDA: C13.2, C14.1, C17.2, C22.2, C23.1, C24.2, C25.1, C26.2, C27.1, C28.1, C29.2, C32.2, C33.1, C34.2, C35.1, C36.1, C37.1, C38.1, D2.1 (K), D4.2 (A), D5.1 (K), FL1.2, J1.S, J2.S, J3.S, J4.S, J5.2, J5.3 (MountPin), J6.10, J7.S, J9.1, JP1.2 (B), R9.2, R10.1, R21.2, R30.1, R31.1, RV2.3, RV2.6, U5.5 (COM), U6.3 (+), U6.5 (+); also elsewhere on the board
unnamed: C15.1, K4.6
unnamed: C16.1, K4.3
unnamed: C36.2, F1.2, L2.1
unnamed: D1.1 (K), R38.1
unnamed: D2.2 (A), R20.1
unnamed: D3.2 (A), R21.1
unnamed: C26.1, D4.1 (K), R1.2, R9.1, U7.1 (ADJ)
unnamed: C27.2, D5.2 (A), R10.2, R17.1, U8.1 (ADJ)
unnamed: D11.1 (K), R42.1
unnamed: D12.1 (K), R43.1
unnamed: J5.1, J8.1
unnamed: F1.1, J8.2
unnamed: K1.4, R37.2
unnamed: K1.5, R32.2
unnamed: RV2.1, U3.1, U3.2 (-)
unnamed: RV2.4, U3.6 (-), U3.7
unnamed: C30.1, FL1.3, U5.1 (Vin+)
unnamed: C31.1, FL1.4, U5.2 (Vin-)
VDD: C13.1, C17.1, C22.1, C24.1, C29.1, D6.2 (A), R1.1, R20.2, TP2.1, U3.8 (V+), U6.8 (V+), U7.2 (VO); also elsewhere on the board
VSS: C14.2, C23.2, C25.2, C28.2, C38.2, D3.1 (K), D7.1 (K), R17.2, TP3.1, U3.4 (V-), U6.4 (V-), U8.3 (VO); also elsewhere on the board

Notes on the sheet:
Output voltage ~+-9V
f(cutoff) = 0,32Hz
Mic Input
Mic Output
Filter arrangement as per datasheet of the DC/DC converter
12V DC
Voltage Amplification Coltage Gain 1x/3x
CTRL > 1.5V -> PSU ON CTRL < 1.5V -> PSU OFF
LED current ~2mA
TODO: DC Output Protection
Current Amplification Voltage gain ~ 2x
Opamp power filtering

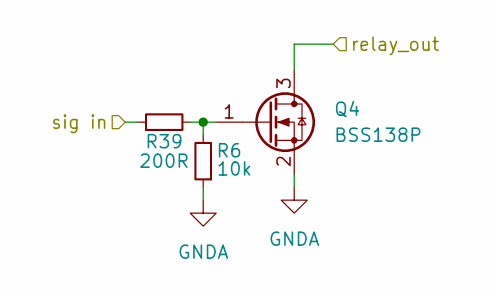
[picture p37: schematic relay_driver.kicad_sch]

Parts:
Q4: BSS138P; SOT-23
R6: 10k; R_0805_2012Metric_Pad1.20x1.40mm_HandSolder
R39: 200R; R_0805_2012Metric_Pad1.20x1.40mm_HandSolder

Connections:
/r_mute: Q4.3 (D); also elsewhere on the board
/sig_mute: R39.1; also elsewhere on the board
GNDA: Q4.2 (S), R6.1; also elsewhere on the board
unnamed: Q4.1 (G), R6.2, R39.2

Parts of its further copies:
Q5, Q6: BSS138P; SOT-23
R18, R19: 10k; R_0805_2012Metric_Pad1.20x1.40mm_HandSolder
R40, R41: 200R; R_0805_2012Metric_Pad1.20x1.40mm_HandSolder

Connections of its further copies:
/r_gain: Q5.3 (D); also elsewhere on the board
/r_in: Q6.3 (D); also elsewhere on the board
/sig_gain: R40.1; also elsewhere on the board
/sig_in: R41.1; also elsewhere on the board
GNDA: Q5.2 (S), Q6.2 (S), R18.1, R19.1; also elsewhere on the board
unnamed: Q5.1 (G), R18.2, R40.2
unnamed: Q6.1 (G), R19.2, R41.2

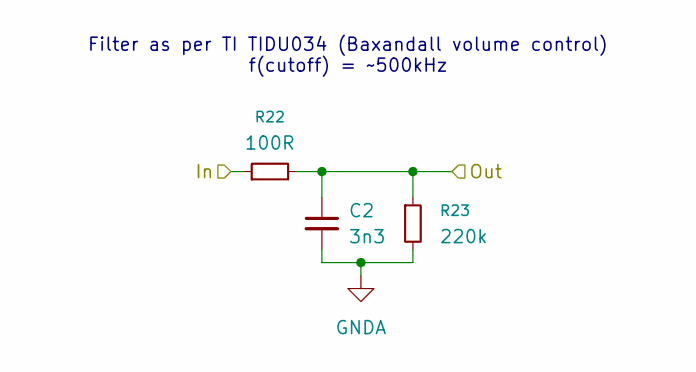
[picture p38: schematic filter_in.kicad_sch]

Parts:
C2: 3n3; C_0805_2012Metric_Pad1.18x1.45mm_HandSolder
R22: 100R; R_0805_2012Metric_Pad1.20x1.40mm_HandSolder
R23: 220k; R_0805_2012Metric_Pad1.20x1.40mm_HandSolder

Connections:
/Input Filter/In: R22.1; also elsewhere on the board
/Input Filter/Out: C2.1, R22.2, R23.1; also elsewhere on the board
GNDA: C2.2, R23.2; also elsewhere on the board

Parts of its further copies:
C3, C8, C9: 3n3; C_0805_2012Metric_Pad1.18x1.45mm_HandSolder
R24, R26, R28: 100R; R_0805_2012Metric_Pad1.20x1.40mm_HandSolder
R25, R27, R29: 220k; R_0805_2012Metric_Pad1.20x1.40mm_HandSolder

Connections of its further copies:
/Input Filter1/In: R24.1; also elsewhere on the board
/Input Filter1/Out: C3.1, R24.2, R25.1; also elsewhere on the board
/Input Filter2/In: R26.1; also elsewhere on the board
/Input Filter2/Out: C8.1, R26.2, R27.1; also elsewhere on the board
/Input Filter3/In: R28.1; also elsewhere on the board
/Input Filter3/Out: C9.1, R28.2, R29.1; also elsewhere on the board
GNDA: C3.2, C8.2, C9.2, R25.2, R27.2, R29.2; also elsewhere on the board

Notes on the sheet:
Filter as per TI TIDU034 (Baxandall volume control) f(cutoff) = ~500kHz

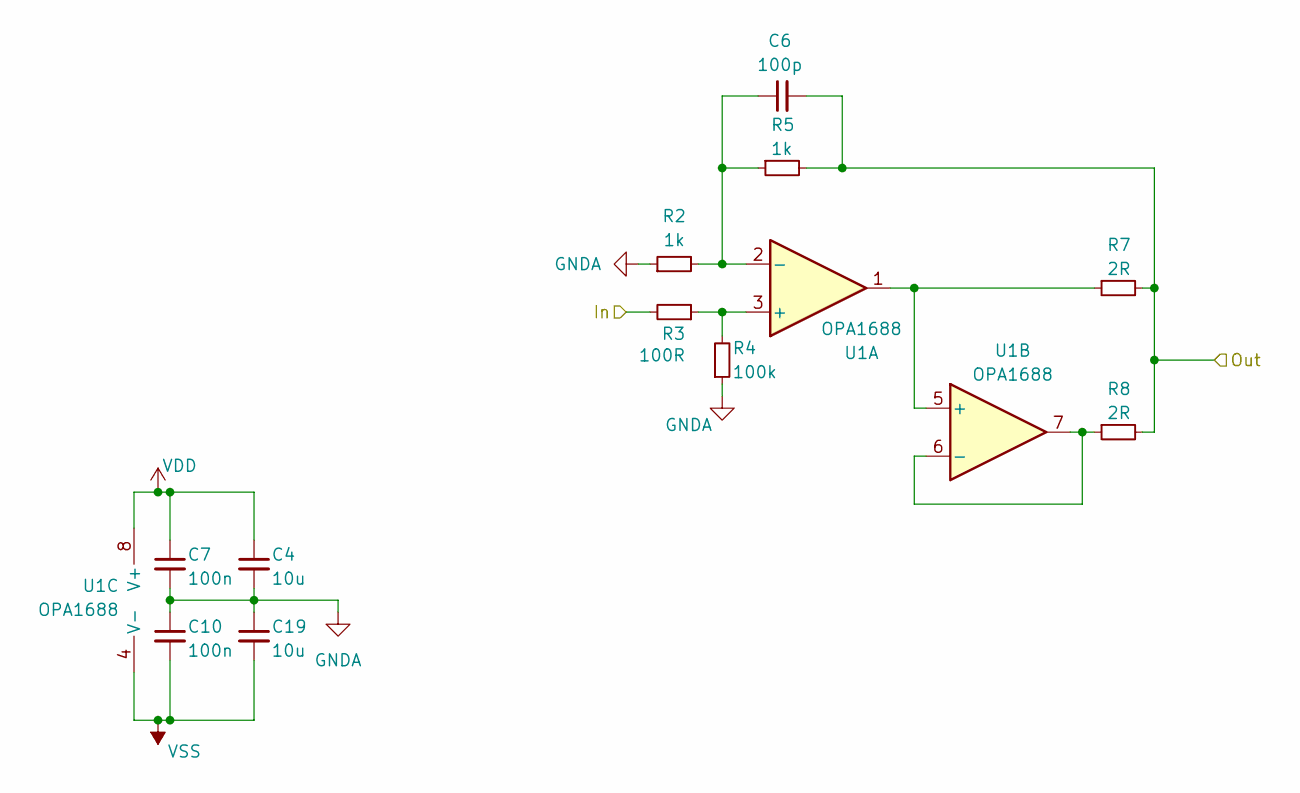
[picture p39: schematic amp.kicad_sch]

Parts:
C4, C19: 10u; CP_Elec_4x5.8
C6: 100p; C_0805_2012Metric_Pad1.18x1.45mm_HandSolder
C7, C10: 100n; C_0805_2012Metric_Pad1.18x1.45mm_HandSolder
R2, R5: 1k; R_0805_2012Metric_Pad1.20x1.40mm_HandSolder
R3: 100R; R_0805_2012Metric_Pad1.20x1.40mm_HandSolder
R4: 100k; R_0805_2012Metric_Pad1.20x1.40mm_HandSolder
R7, R8: 2R; R_0805_2012Metric_Pad1.20x1.40mm_HandSolder
U1: OPA1688; SO-8_3.9x4.9mm_P1.27mm

Connections:
/Amp L/In: R3.2; also elsewhere on the board
/Amp L/Out: C6.2, R5.2, R7.2, R8.2; also elsewhere on the board
GNDA: C4.2, C7.2, C10.1, C19.1, R2.1, R4.1; also elsewhere on the board
unnamed: R3.1, R4.2, U1.3 (+)
unnamed: C6.1, R2.2, R5.1, U1.2 (-)
unnamed: R7.1, U1.1, U1.5 (+)
unnamed: R8.1, U1.6 (-), U1.7
VDD: C4.1, C7.1, U1.8 (V+); also elsewhere on the board
VSS: C10.2, C19.2, U1.4 (V-); also elsewhere on the board

Parts of its further copies:
C5, C20: 10u; CP_Elec_4x5.8
C11, C18: 100n; C_0805_2012Metric_Pad1.18x1.45mm_HandSolder
C21: 100p; C_0805_2012Metric_Pad1.18x1.45mm_HandSolder
R11, R14: 1k; R_0805_2012Metric_Pad1.20x1.40mm_HandSolder
R12: 100R; R_0805_2012Metric_Pad1.20x1.40mm_HandSolder
R13: 100k; R_0805_2012Metric_Pad1.20x1.40mm_HandSolder
R15, R16: 2R; R_0805_2012Metric_Pad1.20x1.40mm_HandSolder
U2: OPA1688; SO-8_3.9x4.9mm_P1.27mm

Connections of its further copies:
/Amp R/In: R12.2; also elsewhere on the board
/Amp R/Out: C21.2, R14.2, R15.2, R16.2; also elsewhere on the board
GNDA: C5.2, C11.2, C18.1, C20.1, R11.1, R13.1; also elsewhere on the board
unnamed: R12.1, R13.2, U2.3 (+)
unnamed: C21.1, R11.2, R14.1, U2.2 (-)
unnamed: R15.1, U2.1, U2.5 (+)
unnamed: R16.1, U2.6 (-), U2.7
VDD: C5.1, C11.1, U2.8 (V+); also elsewhere on the board
VSS: C18.2, C20.2, U2.4 (V-); also elsewhere on the board

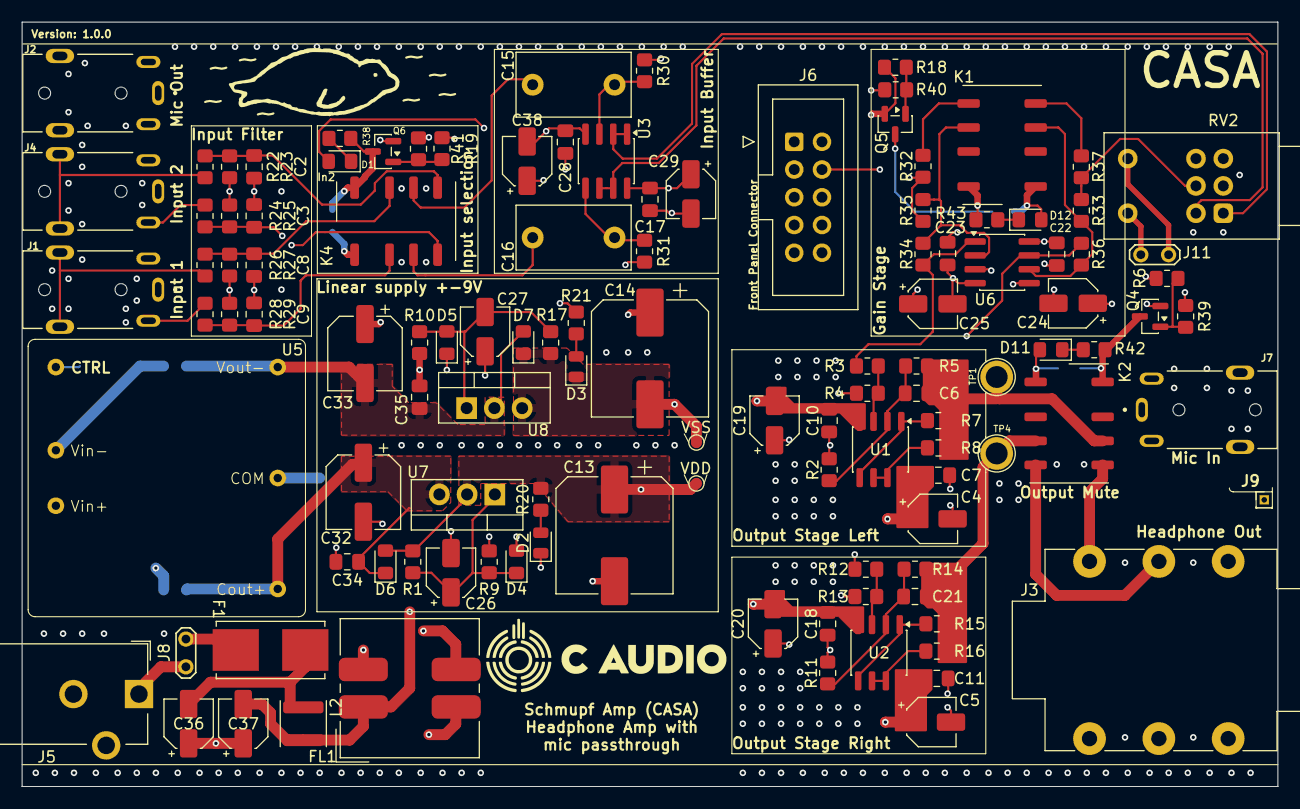
[picture p40: board C-Audio Schmupf Amp (CASA).kicad_pcb from above]

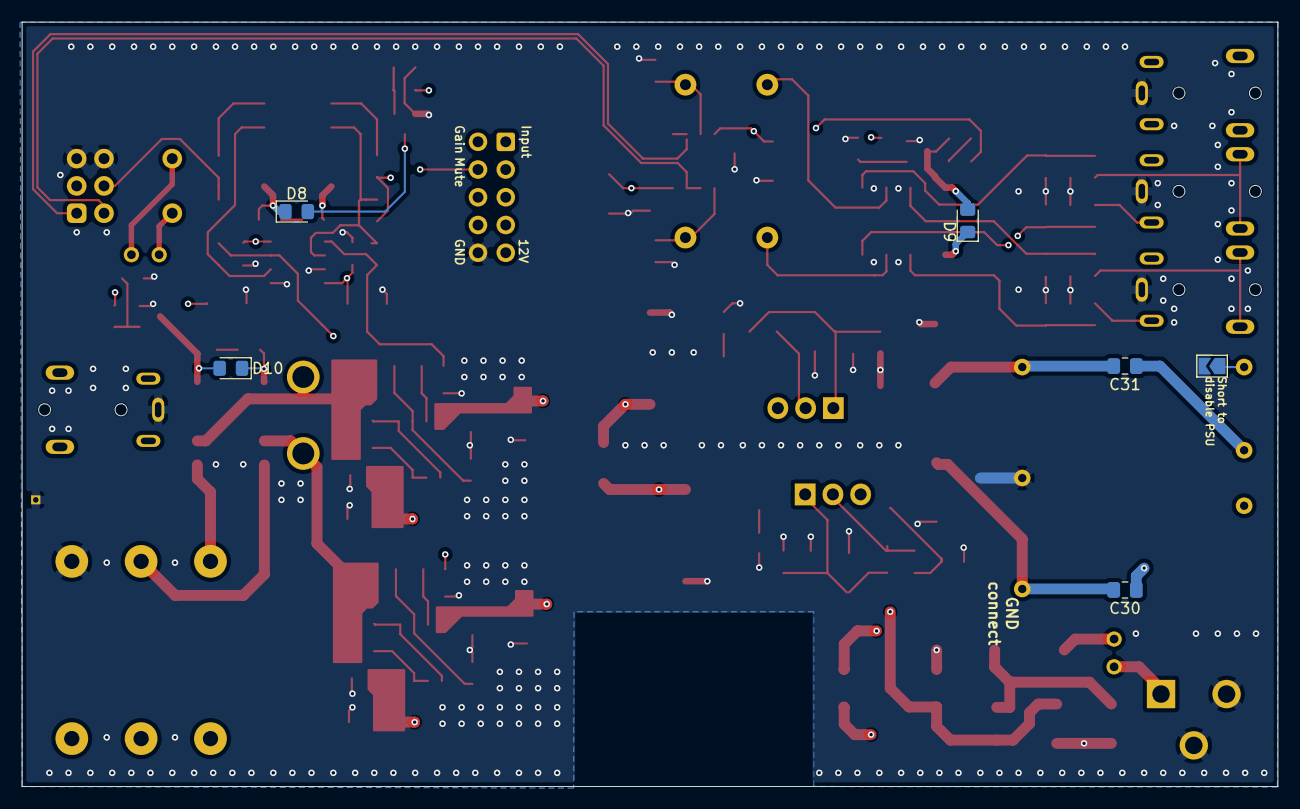
[picture p41: board C-Audio Schmupf Amp (CASA).kicad_pcb from below]

Board: 4 copper layers, 115.0 x 70.0 mm, 123 parts (6 on the bottom side), 66 nets.
