Stustup/C-Audio_Schmupf_Amp_CASA/Hardware/C-Audio Schmupf Amp (CASA) Frontplate/C-Audio Schmupf Amp (CASA) Frontplate.kicad_pcb

## KiCad design Hardware/C-Audio Schmupf Amp (CASA) Frontplate/C-Audio Schmupf Amp (CASA) Frontplate.kicad_pcb (2026-06-09)

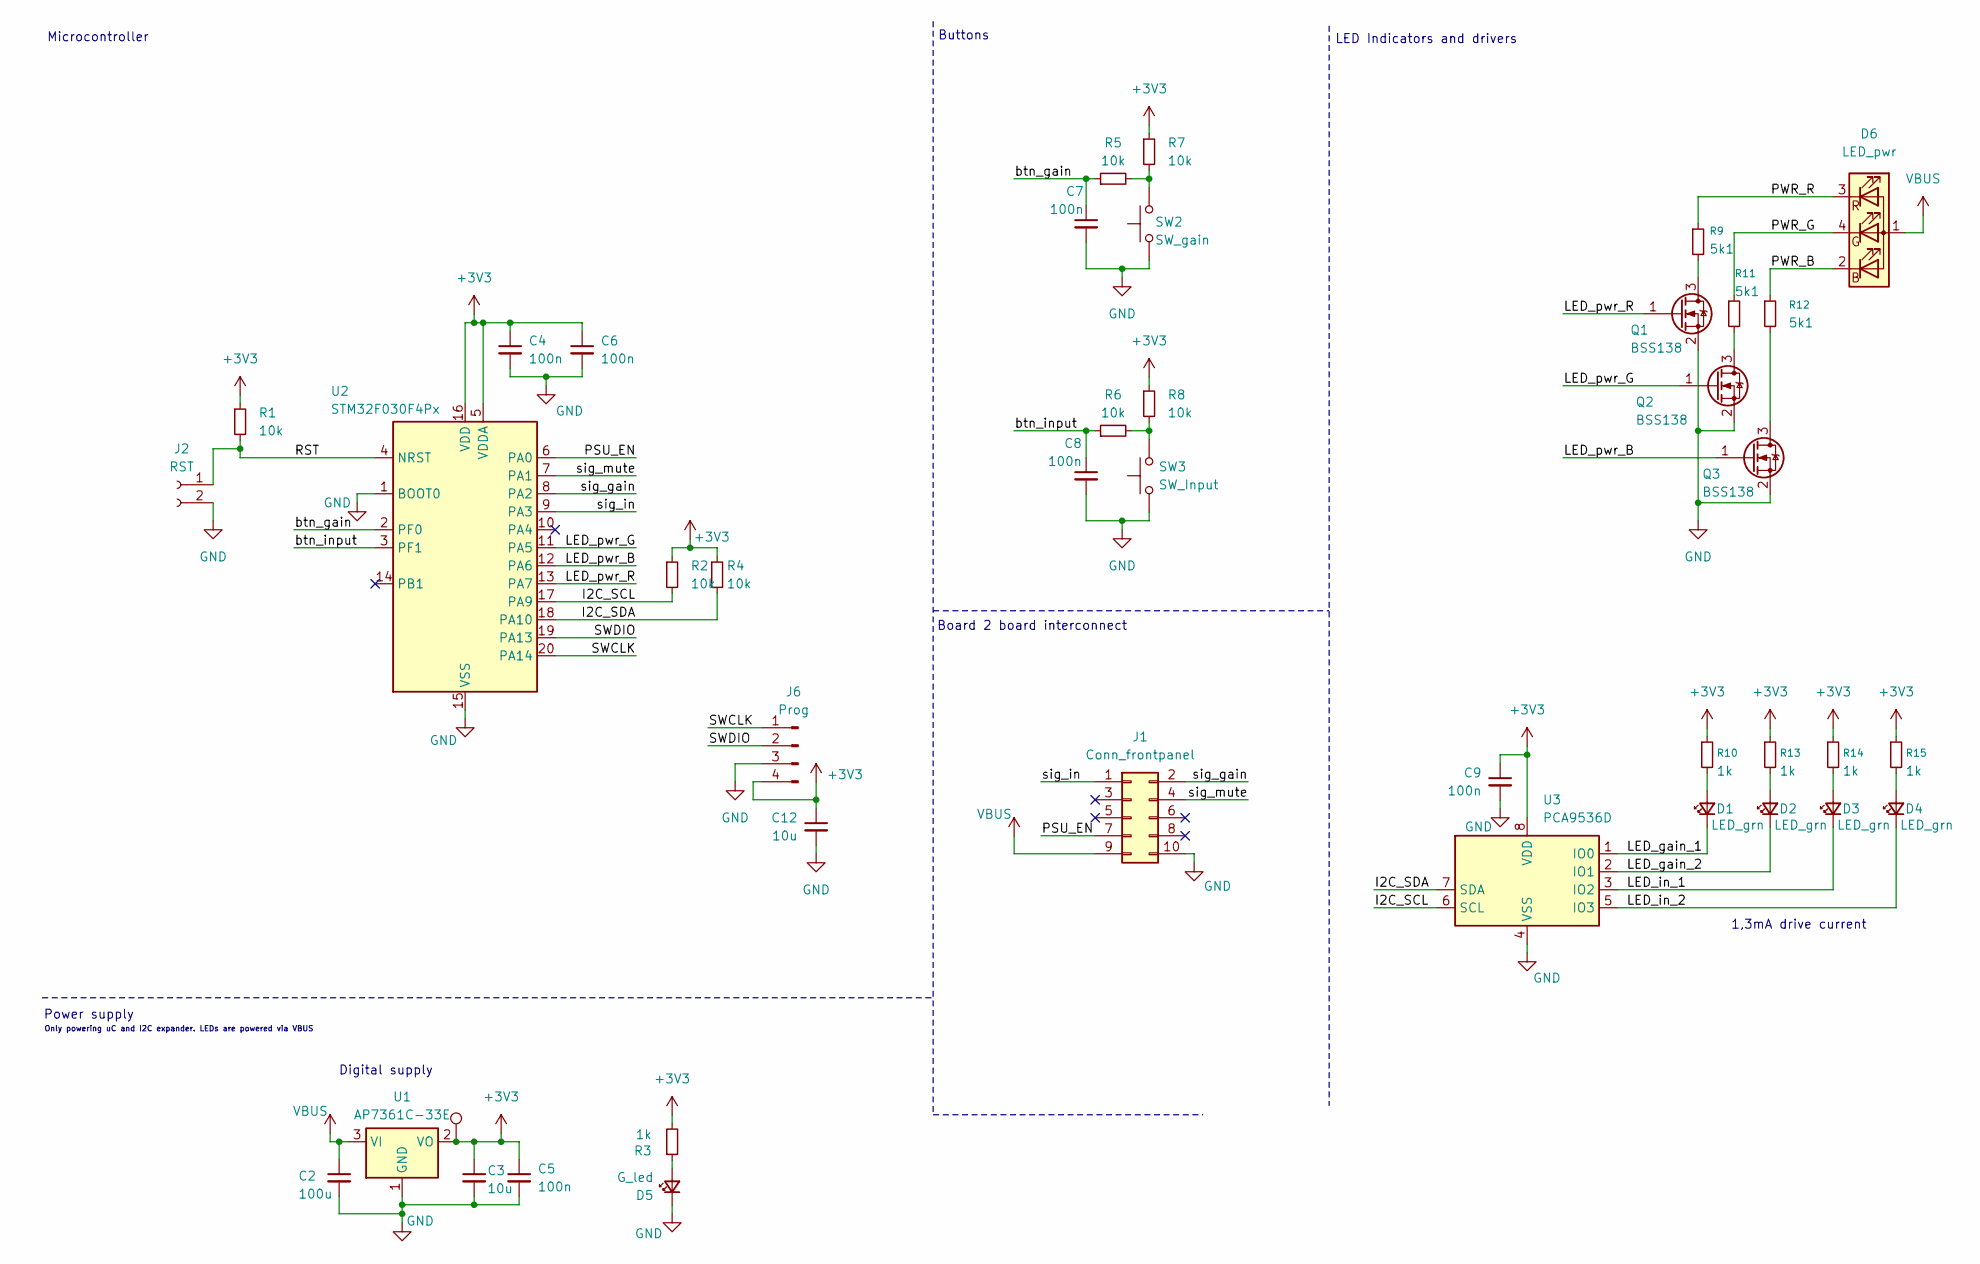
[picture p42: schematic C-Audio Schmupf Amp (CASA) Frontplate.kicad_sch, CASA frontplate]

Parts:
C2: 100u; CP_Elec_4x5.8
C3: 10u; C_0805_2012Metric_Pad1.18x1.45mm_HandSolder
C4, C5, C6, C7, C8, C9: 100n; C_0805_2012Metric_Pad1.18x1.45mm_HandSolder
C12: 10u; C_0805_2012Metric_Pad1.18x1.45mm_HandSolder; Mouser Nr. 187-CL21B106KPQNNNE
D1, D2, D3, D4: LED_grn; LED_0805_2012Metric_Pad1.15x1.40mm_HandSolder
D5: G_led; LED_0805_2012Metric_Pad1.15x1.40mm_HandSolder
D6: LED_pwr; LED_RGB_Wuerth-PLCC4_3.2x2.8mm_150141M173100
J1: Conn_frontpanel; IDC-Header_2x05_P2.54mm_Vertical
J2: RST; SolderJumper-2_P1.3mm_Open_TrianglePad1.0x1.5mm
J6: Prog; PinHeader_1x04_P2.54mm_Vertical
Q1, Q2, Q3: BSS138; SOT-23
R1, R2, R4, R5, R6, R7, R8: 10k; R_0805_2012Metric_Pad1.20x1.40mm_HandSolder
R3, R10, R13, R14, R15: 1k; R_0805_2012Metric_Pad1.20x1.40mm_HandSolder
R9, R11, R12: 5k1; R_0805_2012Metric_Pad1.20x1.40mm_HandSolder
SW2: SW_gain; SW_PUSH_6mm_H13mm
SW3: SW_Input; SW_PUSH_6mm_H13mm
TP1: TestPoint; TestPoint_Pad_D1.0mm
U1: AP7361C-33E; SOT-223-3_TabPin2; Mouser Nr. 621-AP7361C-33ER-13
U2: STM32F030F4Px; TSSOP-20_4.4x6.5mm_P0.65mm
U3: PCA9536D; SOIC-8_3.9x4.9mm_P1.27mm

Connections:
/I2C_SCL: R2.2, U2.17 (PA9), U3.6 (SCL)
/I2C_SDA: R4.2, U2.18 (PA10), U3.7 (SDA)
/LED_gain_1: D1.1 (K), U3.1 (IO0)
/LED_gain_2: D2.1 (K), U3.2 (IO1)
/LED_in_1: D3.1 (K), U3.3 (IO2)
/LED_in_2: D4.1 (K), U3.5 (IO3)
/LED_pwr_B: Q3.1 (G), U2.12 (PA6)
/LED_pwr_G: Q2.1 (G), U2.11 (PA5)
/LED_pwr_R: Q1.1 (G), U2.13 (PA7)
/PSU_EN: J1.7, U2.6 (PA0)
/PWR_B: D6.2 (BK), R12.1
/PWR_G: D6.4 (GK), R11.1
/PWR_R: D6.3 (RK), R9.1
/RST: J2.1, R1.2, U2.4 (NRST)
/SWCLK: J6.1, U2.20 (PA14)
/SWDIO: J6.2, U2.19 (PA13)
/btn_gain: C7.1, R5.1, U2.2 (PF0)
/btn_input: C8.1, R6.1, U2.3 (PF1)
/sig_gain: J1.2, U2.8 (PA2)
/sig_in: J1.1, U2.9 (PA3)
/sig_mute: J1.4, U2.7 (PA1)
GND: C2.2, C3.2, C4.2, C5.2, C6.2, C7.2, C8.2, C9.2, C12.2, D5.1 (K), J1.10, J2.2, J6.3, Q1.2 (S), Q2.2 (S), Q3.2 (S), SW2.1, SW3.1, U1.1 (GND), U2.1 (BOOT0), U2.15 (VSS), U3.4 (VSS)
unnamed: D1.2 (A), R10.2
unnamed: D2.2 (A), R13.2
unnamed: D3.2 (A), R14.2
unnamed: D4.2 (A), R15.2
unnamed: D5.2 (A), R3.1
unnamed: Q1.3 (D), R9.2
unnamed: Q2.3 (D), R11.2
unnamed: Q3.3 (D), R12.2
unnamed: R5.2, R7.2, SW2.2
unnamed: R6.2, R8.2, SW3.2

Notes on the sheet:
Board 2 board interconnect
Microcontroller
Digital supply
Buttons
1,3mA drive current
Only powering uC and I2C expander. LEDs are powered via VBUS
Power supply
LED Indicators and drivers

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
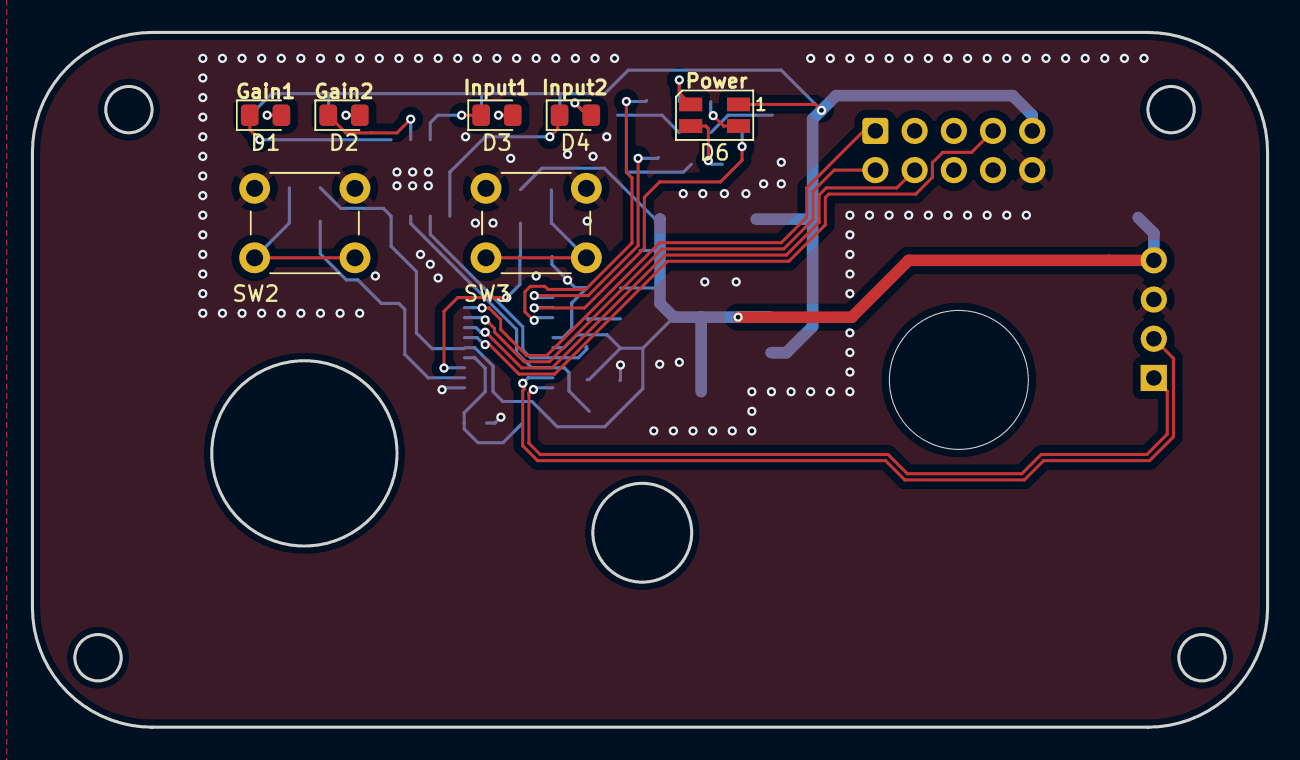
[picture p43: board C-Audio Schmupf Amp (CASA) Frontplate.kicad_pcb from above]

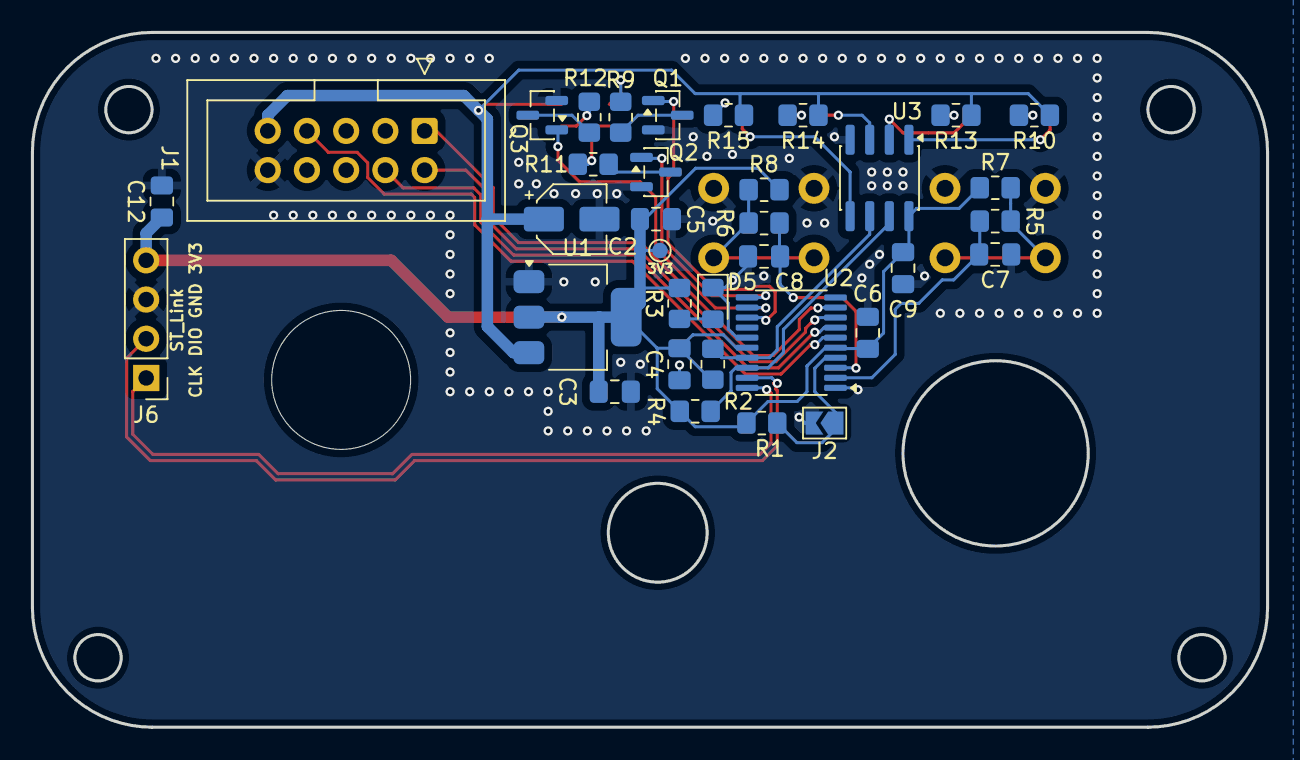
[picture p44: board C-Audio Schmupf Amp (CASA) Frontplate.kicad_pcb from below]

Board: 2 copper layers, 80.0 x 45.0 mm, 42 parts (35 on the bottom side), 34 nets.
