Stustup/C-Audio_Schmupf_Amp_CASA/Hardware/Old Version/CASA old/CASA old.kicad_pcb

## KiCad design Hardware/Old Version/CASA old/CASA old.kicad_pcb (2025-12-11, an earlier design)

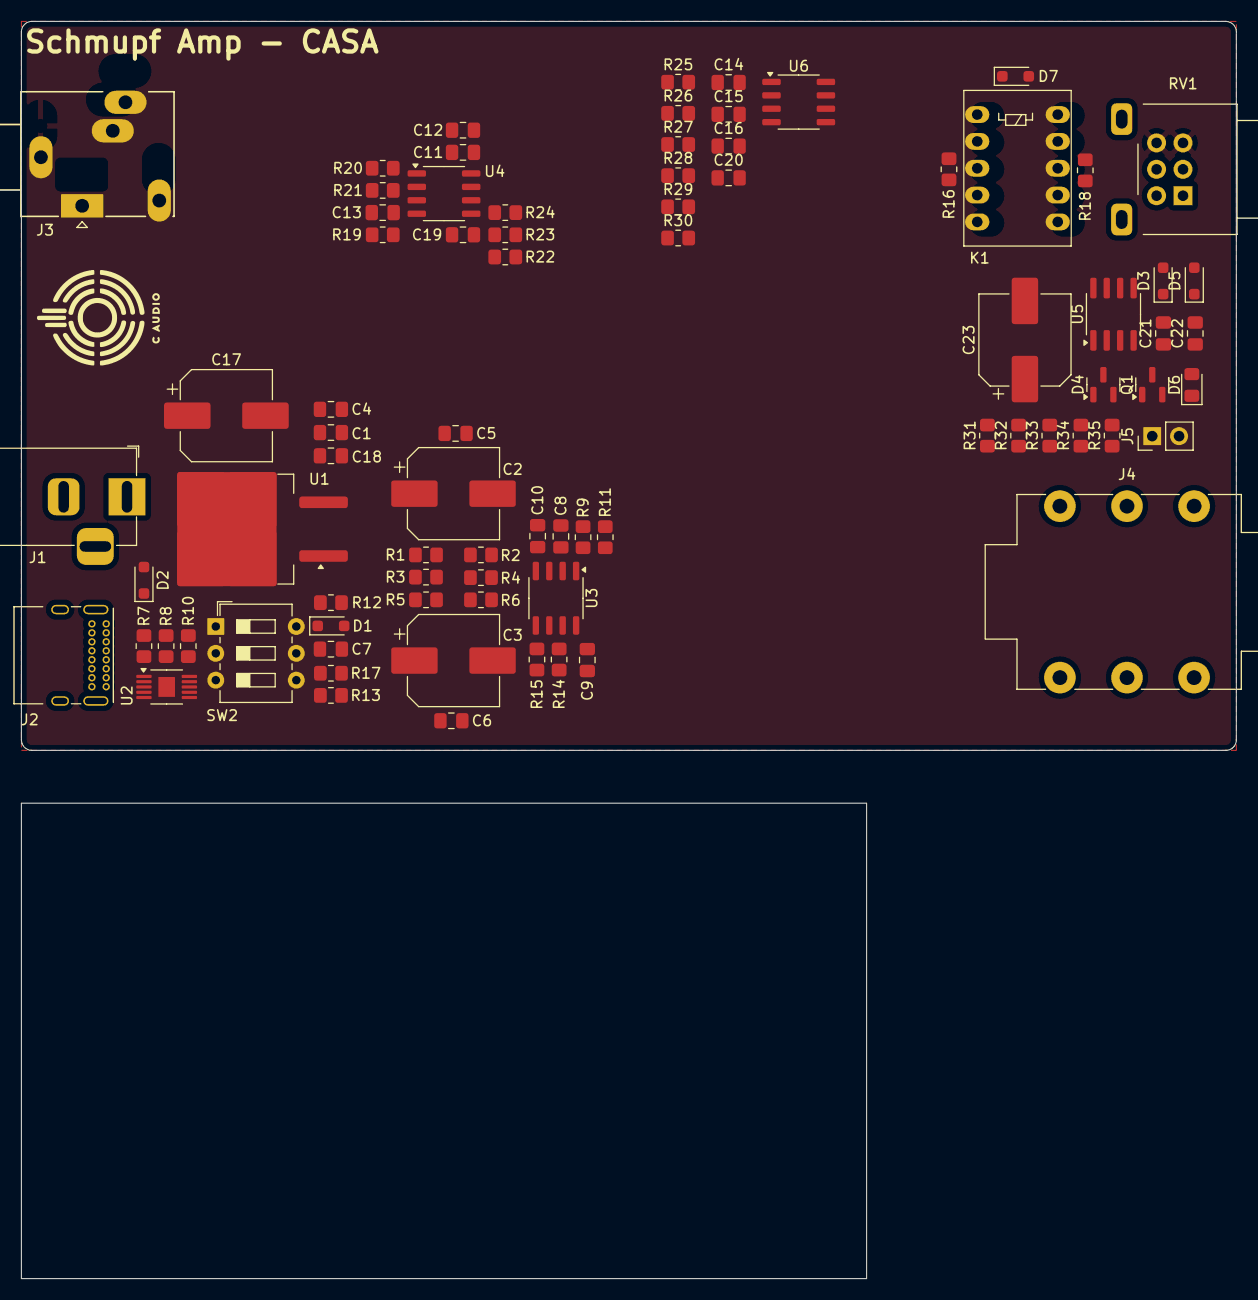
[picture p45: board CASA old.kicad_pcb from above]

Board: 2 copper layers, 115.0 x 69.0 mm, 80 parts (0 on the bottom side), 47 nets, no tracks yet.

Parts:
C1: 10u 35V; C_0805_2012Metric_Pad1.18x1.45mm_HandSolder
C2, C3: 470u; CP_Elec_8x10.5
C4, C5, C6, C8, C9, C10, C11, C12, C13, C14, C15, C16, C18, C21: 100n; C_0805_2012Metric_Pad1.18x1.45mm_HandSolder
C7, C22: 10u; C_0805_2012Metric_Pad1.18x1.45mm_HandSolder
C17: 470u 35V; CP_Elec_8x10.5
C19, C20: 100p; C_0805_2012Metric_Pad1.18x1.45mm_HandSolder
C23: 100u 35V; CP_Elec_8x10.5
D1, D3, D7: 1N4001; D_SOD-323_HandSoldering
D2: D_Small; D_SOD-323_HandSoldering
D4: 5V6 Zener; SOT-23
D5: 1N4148; D_SOD-323_HandSoldering
D6: LED_grn; D_0805_2012Metric_Pad1.15x1.40mm_HandSolder
J1: Barrel_Jack_Switch; BarrelJack_Horizontal
J2: USB_C_Receptacle; USB_C_Receptacle_GCT_USB4085
J3: Audio In; Jack_3.5mm_Ledino_KB3SPRS_Horizontal
J4: Audio Out; Jack_6.35mm_Neutrik_NMJ6HFD2-AU_Horizontal
J5: Manual Relay; PinHeader_1x02_P2.54mm_Vertical
K1: FRT5; Relay_DPDT_FRT5
Q1: 2N7002; SOT-23
R1, R2, R3, R4, R5, R6: 33k; R_0805_2012Metric_Pad1.20x1.40mm_HandSolder
R7: 1k; R_0805_2012Metric_Pad1.20x1.40mm_HandSolder
R8, R16, R18, R33, R34, R35: 10k; R_0805_2012Metric_Pad1.20x1.40mm_HandSolder
R9, R11: 330R; R_0805_2012Metric_Pad1.20x1.40mm_HandSolder
R10: 24k; R_0805_2012Metric_Pad1.20x1.40mm_HandSolder
R12, R31: 240R; R_0805_2012Metric_Pad1.20x1.40mm_HandSolder
R13: 1k5; R_0805_2012Metric_Pad1.20x1.40mm_HandSolder
R14, R15, R23, R24, R29, R30: 1R; R_0805_2012Metric_Pad1.20x1.40mm_HandSolder
R17: 3k2; R_0805_2012Metric_Pad1.20x1.40mm_HandSolder
R19, R20, R25, R26: 470R; R_0805_2012Metric_Pad1.20x1.40mm_HandSolder
R21, R27: 100k; R_0805_2012Metric_Pad1.20x1.40mm_HandSolder
R22, R28: 940R; R_0805_2012Metric_Pad1.20x1.40mm_HandSolder
R32: 2k; R_0805_2012Metric_Pad1.20x1.40mm_HandSolder
RV1: 10kA; Potentiometer_Alps_RK09L_Double_Horizontal
SW2: Voltage Select; SW_DIP_SPSTx03_Slide_6.7x9.18mm_W7.62mm_P2.54mm_LowProfile
U1: LM317_TO-263; TO-263-2
U2: CH224K; HVSSOP-10-1EP_3x3mm_P0.5mm_EP1.57x1.88mm
U3: OPA1688; SO-8_3.9x4.9mm_P1.27mm
U4, U6: OPA1662; SO-8_3.9x4.9mm_P1.27mm
U5: LM317L_SO8; SOIC-8_3.9x4.9mm_P1.27mm

Connections:
+12V: C1.1, C4.1, D1.1 (K), D2.1 (K), D3.2 (A), D6.2 (A), J2.A4 (VBUS), J2.A9 (VBUS), J2.B4 (VBUS), J2.B9 (VBUS), R7.1, R8.1, R31.1, U1.3 (VI), U5.2 (VO), U5.3 (VO), U5.6 (VO), U5.7 (VO)
+12V_2: D5.1 (K), D7.1 (K), K1.1, R33.1
/Adj V-reg: C7.1, R12.2, SW2.1, SW2.2, U1.1 (ADJ)
/Amp_In_L: R20.1, RV1.2
/Amp_In_R: R26.1, RV1.5
/In_L: J3.T, K1.8
/In_R: J3.R, K1.3
/Out_L: J4.T, R23.2, R24.2
/Out_R: J4.R, R29.2, R30.2
/USBC PD: SW2.3, U2.9 (CFG1)
/r_mute: D7.2 (A), J5.1, K1.10, Q1.3 (D), R35.2
GND: C1.2, C3.2, C4.2, C6.2, C7.2, C11.2, C13.2, C14.2, C16.2, C17.2, C18.2, C21.2, C22.2, C23.2, J1.2, J2.A1 (GND), J2.A12 (GND), J2.B1 (GND), J2.B12 (GND), J5.2, Q1.2 (S), R2.2, R4.2, R6.2, R10.2, R13.2, R17.2, R32.2, R34.2, U2.11 (GND), U4.4 (V-), U6.4 (V-)
InGND: C2.2, C3.1, C5.2, C6.1, C9.2, C10.1, C12.2, C13.1, C15.2, C16.1, J3.S, R1.2, R2.1, R3.2, R4.1, R5.2, R6.1, R9.1, R19.1, R21.1, R25.1, R27.1, RV1.3, RV1.6
unnamed: D2.2 (A), J1.1
unnamed: D4.1 (A), D5.2 (A), Q1.1 (G), R34.1
unnamed: C23.1, D4.3 (K), R33.2
unnamed: D6.1 (K), R35.1
unnamed: J2.A5 (CC1), U2.7 (CC1)
unnamed: J2.B5 (CC2), U2.6 (CC2)
unnamed: K1.2, R16.2, RV1.4
unnamed: K1.4, R16.1
unnamed: K1.7, R18.1
unnamed: K1.9, R18.2, RV1.1
unnamed: R10.1, SW2.4
unnamed: R13.1, SW2.5
unnamed: R14.1, U3.7
unnamed: R17.1, SW2.6
unnamed: J2.A6 (D+), J2.B6 (D+), U2.5 (DM)
unnamed: J2.A7 (D-), J2.B7 (D-), U2.4 (DP)
unnamed: R8.2, U2.8 (VBUS)
unnamed: R7.2, U2.1 (VDD)
unnamed: R9.2, U3.3 (+)
unnamed: R11.1, U3.2 (-)
unnamed: R15.1, U3.1, U3.5 (+)
unnamed: C8.1, C9.1, U3.8 (V+)
unnamed: C8.2, C10.2, U3.4 (V-)
unnamed: R20.2, R21.2, U4.3 (+)
unnamed: C19.1, R19.2, R22.1, U4.2 (-)
unnamed: C19.2, R22.2, R23.1, U4.1, U4.5 (+)
unnamed: R24.1, U4.6 (-), U4.7
unnamed: C22.1, R31.2, R32.1, U5.4 (ADJ)
unnamed: R26.2, R27.2, U6.3 (+)
unnamed: C20.1, R25.2, R28.1, U6.2 (-)
unnamed: C20.2, R28.2, R29.1, U6.1, U6.5 (+)
unnamed: R30.1, U6.6 (-), U6.7
OpGND: J4.S, R11.2, R14.2, R15.2, U3.6 (-)
VDD: C2.1, C5.1, C11.1, C12.1, C14.1, C15.1, C17.1, C18.1, C21.1, D1.2 (A), D3.1 (K), R1.1, R3.1, R5.1, R12.1, U1.2 (VO), U4.8 (V+), U5.1 (VI), U6.8 (V+)
