Stustup/C-Audio_Schmupf_Amp_CASA/Firmware/CASA/Core/Src/main.c

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
/* Includes ------------------------------------------------------------------*/
#include "main.h"

/* USER CODE BEGIN Includes */
#include "PCA9536.h"
#include "stm32f0xx_hal.h"
#include "stm32f0xx_hal_gpio.h"
#include <stdint.h>
/* USER CODE END Includes */

/* USER CODE BEGIN PM */
#define RED 1
#define GREEN 2
#define BLUE 3

#define BOOTUP_TIME 2500
#define BLINK_TIME 250
#define BLINK_TIME_PCA 100
/* USER CODE END PM */

I2C_HandleTypeDef hi2c1;

/* USER CODE BEGIN PV */
//Button flags
volatile uint8_t btnFlag_gain  = 0;
volatile uint8_t btnFlag_input = 0;

uint8_t PCA9536_defaultOutput = 0x0A;

uint32_t Timestamp_ms;
uint32_t Timestamp_ms_led;
uint32_t Timestamp_ms_pca;
uint8_t firstBoot = 1;
/* USER CODE END PV */

void SystemClock_Config(void);
static void MX_GPIO_Init(void);
static void MX_I2C1_Init(void);
/**
  * @brief  The application entry point.
  * @retval int
  */
int main(void)
{

  /* MCU Configuration--------------------------------------------------------*/

  /* Reset of all peripherals, Initializes the Flash interface and the Systick. */
  HAL_Init();

  /* Configure the system clock */
  SystemClock_Config();

  /* Initialize all configured peripherals */
  MX_GPIO_Init();
  MX_I2C1_Init();
  /* USER CODE BEGIN 2 */

  //Set red led for boot
  frontLED_set(RED);

  //Setup the IO Expander via I2C
  PCA9536 pca9536;

  PCA9536_Init(&pca9536, &hi2c1);
  PCA9536_configPinOutput(&pca9536);                                                            //Set pinmode to output

  //Get timestamp for boot sequence
  Timestamp_ms = HAL_GetTick();
  Timestamp_ms_led = Timestamp_ms;
  /* USER CODE END 2 */

  /* Infinite loop */
  /* USER CODE BEGIN WHILE */

  //Boot animation and init
  uint8_t _counter_PCA = 0; 

  #ifdef ANIMATION1
  uint8_t _animationArray1[4] = {0x0E, 0x0D, 0x0B, 0x07};
  #endif

  #ifdef ANIMATION2
  uint8_t _animationArray2[8] = {0x0F, 0x0E, 0x0C, 0x08, 0x00, 0x08, 0x0C, 0x0E};
  #endif

  while(firstBoot) {

    uint32_t _current_Timestamp_ms = HAL_GetTick();

    //Blink red led as long as analog circuitry needs to settle
    if(_current_Timestamp_ms >= Timestamp_ms_led+BLINK_TIME) {
      HAL_GPIO_TogglePin(frontLED_red_GPIO_Port, frontLED_red_Pin);
      Timestamp_ms_led = Timestamp_ms_led+BLINK_TIME;
    }

    //Cute little animation for bootup time
    if(_current_Timestamp_ms >= Timestamp_ms_pca+BLINK_TIME_PCA) {

      #ifdef ANIMATION1
      PCA9536_write(&pca9536, PCA9536_outputRegister, &_animationArray1[_counter_PCA]);
      
      if(_counter_PCA > 3) _counter_PCA = 0;
      #endif
      
      #ifdef ANIMATION2
      PCA9536_write(&pca9536, PCA9536_outputRegister, &_animationArray2[_counter_PCA]);
      
      if(_counter_PCA > 7) _counter_PCA = 0;
      #endif

      _counter_PCA++;
      Timestamp_ms_pca = Timestamp_ms_pca+BLINK_TIME_PCA;
    } 

    //When settled, set front power led to green, deactivate mute and turn off first_boot-mode
    if(_current_Timestamp_ms > Timestamp_ms+BOOTUP_TIME) {
      frontLED_set(GREEN);
      mute(0);
      firstBoot = 0;
    }
  }

  PCA9536_write(&pca9536, PCA9536_outputRegister, &PCA9536_defaultOutput);      //Sets the defualt output (gain 0 and input 0)

  while (1)
  {

    if(btnFlag_gain) {
      PCA9536_switchPort(&pca9536, 0);
      HAL_GPIO_WritePin(ext_gain_GPIO_Port, ext_gain_Pin, pca9536._port0);
      btnFlag_gain = 0;
    }

    if(btnFlag_input) {
      PCA9536_switchPort(&pca9536, 1);
      HAL_GPIO_WritePin(ext_input_GPIO_Port, ext_input_Pin, pca9536._port1);
      btnFlag_input = 0;
    }
    /* USER CODE END WHILE */

    /* USER CODE BEGIN 3 */
  }
  /* USER CODE END 3 */
}

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
/* USER CODE BEGIN 4 */

/**
 * @brief Sets front leds, only one colour at a time
 * @param led: 
 *  1 -> RED
 *  2 -> GREEN
 *  3 -> BLUE
 */
void frontLED_set(uint8_t led) {
  switch (led) {
    case 1: 
      HAL_GPIO_WritePin(frontLED_red_GPIO_Port, frontLED_red_Pin, 1);
      HAL_GPIO_WritePin(frontLED_grn_GPIO_Port, frontLED_grn_Pin, 0);
      HAL_GPIO_WritePin(frontLED_blu_GPIO_Port, frontLED_blu_Pin, 0);
      break;
    case 2: 
      HAL_GPIO_WritePin(frontLED_red_GPIO_Port, frontLED_red_Pin, 0);
      HAL_GPIO_WritePin(frontLED_grn_GPIO_Port, frontLED_grn_Pin, 1);
      HAL_GPIO_WritePin(frontLED_blu_GPIO_Port, frontLED_blu_Pin, 0);
      break;
    case 3: 
      HAL_GPIO_WritePin(frontLED_red_GPIO_Port, frontLED_red_Pin, 0);
      HAL_GPIO_WritePin(frontLED_grn_GPIO_Port, frontLED_grn_Pin, 0);
      HAL_GPIO_WritePin(frontLED_blu_GPIO_Port, frontLED_blu_Pin, 1);
      break;
    default:
      HAL_GPIO_WritePin(frontLED_red_GPIO_Port, frontLED_red_Pin, 0);
      HAL_GPIO_WritePin(frontLED_grn_GPIO_Port, frontLED_grn_Pin, 0);
      HAL_GPIO_WritePin(frontLED_blu_GPIO_Port, frontLED_blu_Pin, 0);
      break;
  }
}

/**
 * @brief Sets the mute relay
 * @param value: 
 * 0 -> mute off
 * 1 -> mute on
 */
void mute(uint8_t value) {
  HAL_GPIO_WritePin(ext_mute_GPIO_Port, ext_mute_Pin, value);
}

void HAL_GPIO_EXTI_Callback(uint16_t GPIO_Pin) {
  if(GPIO_Pin == btn_gain_Pin) btnFlag_gain = 1;
  if(GPIO_Pin == btn_input_Pin) btnFlag_input = 1;
}
/* USER CODE END 4 */
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
