Stustup/C-Audio_Schmupf_Amp_CASA/Firmware/CASA/CASA.ioc

Mcu.UserName=STM32F030F4Px
PA0.GPIO_Label=ext_PSU-en
PA0.Signal=GPIO_Output
PA1.GPIO_Label=ext_mute
PA1.Signal=GPIO_Output
PA10.Signal=I2C1_SDA
PA13.Signal=SYS_SWDIO
PA14.Signal=SYS_SWCLK
PA2.GPIO_Label=ext_gain
PA2.Signal=GPIO_Output
PA3.GPIO_Label=ext_input
PA3.Signal=GPIO_Output
PA5.GPIO_Label=frontLED_grn
PA5.Signal=GPIO_Output
PA6.GPIO_Label=frontLED_blu
PA6.Signal=GPIO_Output
PA7.GPIO_Label=frontLED_red
PA7.Signal=GPIO_Output
PA9.Signal=I2C1_SCL
PF0-OSC_IN.GPIO_Label=btn_gain
PF0-OSC_IN.Signal=GPXTI0
PF1-OSC_OUT.GPIO_Label=btn_input
PF1-OSC_OUT.Signal=GPXTI1
