Stustup/C-Audio_Schmupf_Amp_CASA/Firmware/CASA/Core/Inc/main.h

#define HIGH 1
#define LOW 0
#define OFF 0
#define btn_gain_Pin GPIO_PIN_0
#define btn_gain_GPIO_Port GPIOF
#define btn_gain_EXTI_IRQn EXTI0_1_IRQn
#define btn_input_Pin GPIO_PIN_1
#define btn_input_GPIO_Port GPIOF
#define btn_input_EXTI_IRQn EXTI0_1_IRQn
#define ext_PSU_en_Pin GPIO_PIN_0
#define ext_PSU_en_GPIO_Port GPIOA
#define ext_mute_Pin GPIO_PIN_1
#define ext_mute_GPIO_Port GPIOA
#define ext_gain_Pin GPIO_PIN_2
#define ext_gain_GPIO_Port GPIOA
#define ext_input_Pin GPIO_PIN_3
#define ext_input_GPIO_Port GPIOA
#define frontLED_grn_Pin GPIO_PIN_5
#define frontLED_grn_GPIO_Port GPIOA
#define frontLED_blu_Pin GPIO_PIN_6
#define frontLED_blu_GPIO_Port GPIOA
#define frontLED_red_Pin GPIO_PIN_7
#define frontLED_red_GPIO_Port GPIOA
