Stustup/C-Audio_Schmupf_Amp_CASA/(commit log)

2025-12-11 added project
    [Audio Jack 3.5 mm Cliff FC68125.step, BarrelJack_Horizontal.step, C-Audio Schmupf Amp (CASA) Backplate.kicad_pcb, C-Audio Schmupf Amp (CASA) Backplate.kicad_sch, C-Audio Schmupf Amp (CASA) Backplate.step, C-Audio Schmupf Amp (CASA) Frontplate.kicad_pcb, C-Audio Schmupf Amp (CASA) Frontplate.kicad_sch, C-Audio Schmupf Amp (CASA) Frontplate.step]
2025-12-11 changed relays to 12V for easier power distribution
    [C-Audio Schmupf Amp (CASA) Frontplate.kicad_pcb, C-Audio Schmupf Amp (CASA) Frontplate.kicad_sch, C-Audio Schmupf Amp (CASA).kicad_pcb, C-Audio Schmupf Amp (CASA).kicad_sch, amp.kicad_sch, filter_in.kicad_sch, relay_driver.kicad_sch]
2025-12-11 new project structure
    [Audio Jack 3.5 mm Cliff FC68125.step, BarrelJack_Horizontal.step, C-Audio Schmupf Amp (CASA) Backplate.kicad_pcb, C-Audio Schmupf Amp (CASA) Backplate.kicad_sch, C-Audio Schmupf Amp (CASA) Backplate.step, C-Audio Schmupf Amp (CASA) Frontplate.kicad_pcb, C-Audio Schmupf Amp (CASA) Frontplate.kicad_sch, C-Audio Schmupf Amp (CASA) Frontplate.step]
2025-12-11 added 3D Model of case and pcb
    [Schmupf amp CASA.FCStd]
2025-12-11 Added Text indicators and TP designators
    [C-Audio Schmupf Amp (CASA).kicad_pcb, C-Audio Schmupf Amp (CASA).kicad_sch]
2025-12-11 Added simple readme and docs
    [uC.kicad_sch]
2025-12-15 improved routing and added TODOS
    [C-Audio Schmupf Amp (CASA) Frontplate.kicad_sch, C-Audio Schmupf Amp (CASA).kicad_pcb, C-Audio Schmupf Amp (CASA).kicad_sch]
2025-12-15 Finished power wiring
    [C-Audio Schmupf Amp (CASA).kicad_pcb, C-Audio Schmupf Amp (CASA).kicad_sch]
2025-12-15 added vias to signal paths
    [C-Audio Schmupf Amp (CASA).kicad_pcb]
2026-01-21 Finmished front board
    [C-Audio Schmupf Amp (CASA) Frontplate.kicad_pcb, C-Audio Schmupf Amp (CASA) Frontplate.kicad_sch, C-Audio Schmupf Amp (CASA) Frontplate.step, C-Audio Schmupf Amp (CASA).kicad_pcb, Schmupf amp CASA.FCStd, led_single.kicad_sch, relay_driver.kicad_sch]
2026-03-26 combined GNDs and finalized egrbers
    [C-Audio Schmupf Amp (CASA)-B_Cu.gbr, C-Audio Schmupf Amp (CASA)-B_Mask.gbr, C-Audio Schmupf Amp (CASA)-B_Paste.gbr, C-Audio Schmupf Amp (CASA)-B_Silkscreen.gbr, C-Audio Schmupf Amp (CASA)-Edge_Cuts.gbr, C-Audio Schmupf Amp (CASA)-F_Cu.gbr, C-Audio Schmupf Amp (CASA)-F_Mask.gbr, C-Audio Schmupf Amp (CASA)-F_Paste.gbr]
2026-06-09 Finalized placement, pcb and schematic. Firmware WIP
    [C-Audio Schmupf Amp (CASA) Frontplate-B_Cu.gbr, C-Audio Schmupf Amp (CASA) Frontplate-B_Mask.gbr, C-Audio Schmupf Amp (CASA) Frontplate-B_Paste.gbr, C-Audio Schmupf Amp (CASA) Frontplate-B_Silkscreen.gbr, C-Audio Schmupf Amp (CASA) Frontplate-Edge_Cuts.gbr, C-Audio Schmupf Amp (CASA) Frontplate-F_Cu.gbr, C-Audio Schmupf Amp (CASA) Frontplate-F_Mask.gbr, C-Audio Schmupf Amp (CASA) Frontplate-F_Pas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]
