Stustup/C-Audio_Schmupf_Amp_CASA/(notices)

Notices in the files:
Hardware/3D-models/IDC-Header_2x05_P2.54mm_Vertical.step:
Copyright (C) 2017, kicad StepUp
This work is licensed under the [Creative Commons CC-BY-SA 4.0 License](https://creativecommons.org/licenses/by-sa/4.0/legalcode),
with the following exception:
To the extent that the creation of electronic designs that use 'Licensed Material' can be considered to be 'Adapted Material',
You are free to use the library data in your own projects without the obligation to share your project files under this or any other license agreement.
Hardware/3D-models/CP_Elec_4x5.8.step:
Copyright (C) 2018, kicad StepUp
Hardware/3D-models/C_Rect_L10.3mm_W5.7mm_P7.50mm_MKS4.step:
This program is free software: you can redistribute it and/or modify
it under the terms of the GNU General Public License as published by
the Free Software Foundation, either version 3 of the License, or
any later version.
itself might be covered by the GNU General Public License.
Hardware/3D-models/SO-8_3.9x4.9mm_P1.27mm.step:
Copyright (C) 2025, KiCAD
This work is licensed under the
[Creative Commons CC-BY-SA 4.0 License](https://creativecommons.org/licenses/by-sa/4.0/legalcode),
project files under this or any other license agreement. However, if you wish to distribute
Hardware/3D-models/Relay_DPDT_Kemet_EE2_NU.step:
Copyright (C) 2024, KiCAD
Firmware/CASA/Core/Inc/main.h:
Copyright (c) 2026 STMicroelectronics.
All rights reserved.
This software is licensed under terms that can be found in the LICENSE file
